maolin2501/REBOOT_RS/reBot-DevArm/media/certification-mark-CN000024-stacked.png

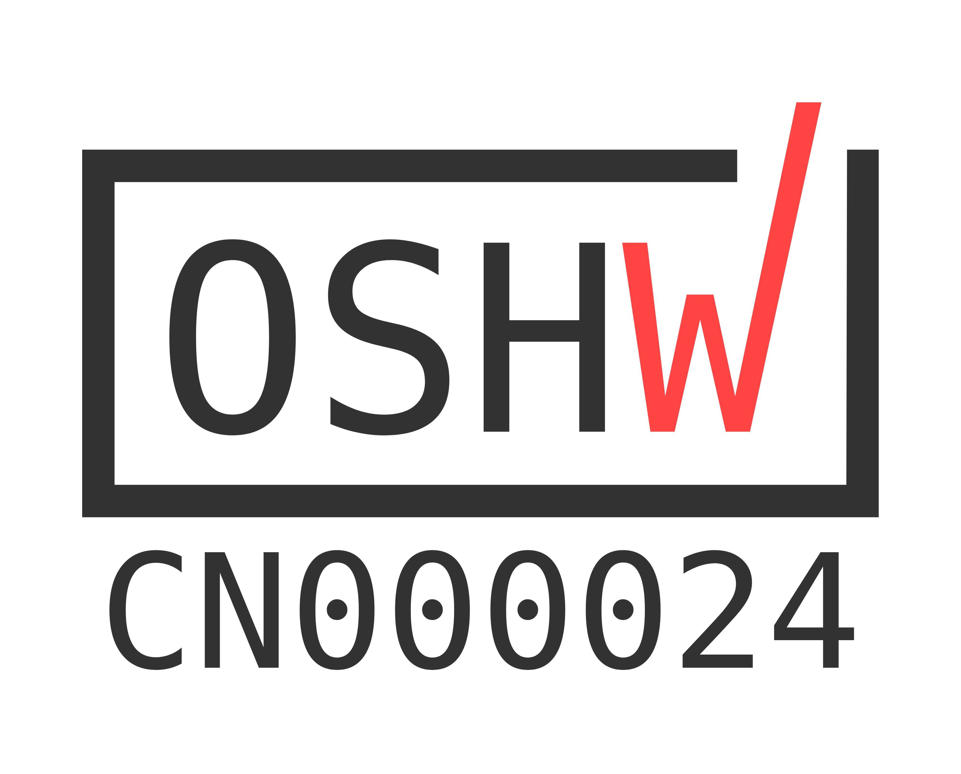
reBot-DevArm/media/certification-mark-CN000024-stacked.png
