maolin2501/REBOOT_RS/reBot-DevArm/media/v1.1_2.png

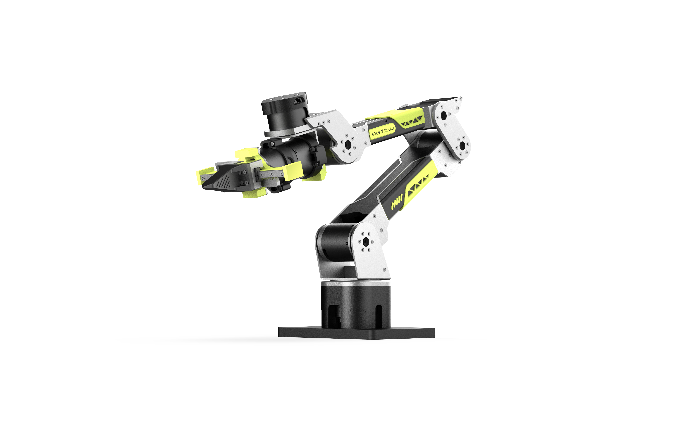
reBot-DevArm/media/v1.1_2.png
