maolin2501/REBOOT_RS/reBotArm_control_py/data/torque_fit_compare.png

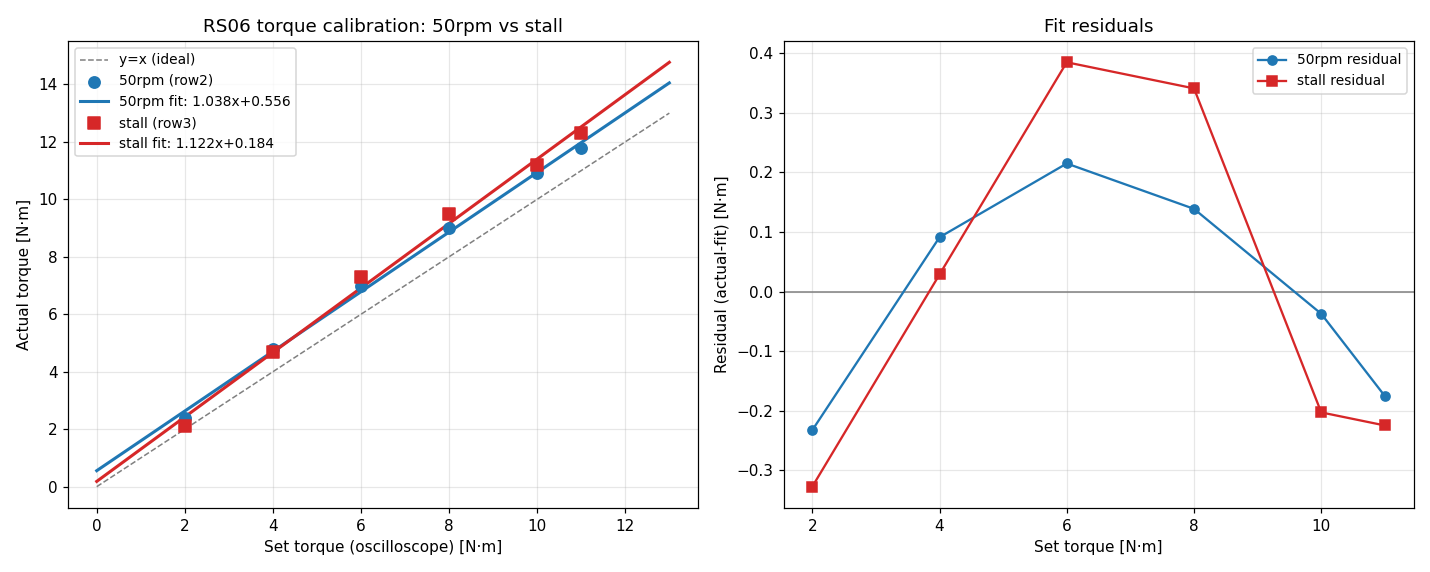
reBotArm_control_py/data/torque_fit_compare.png
