maolin2501/REBOOT_RS/reBot-DevArm/hardware/reBot_B601_DM/3D_Printed_Parts/images/01_Joint6_7_Cable Restraint_A.png

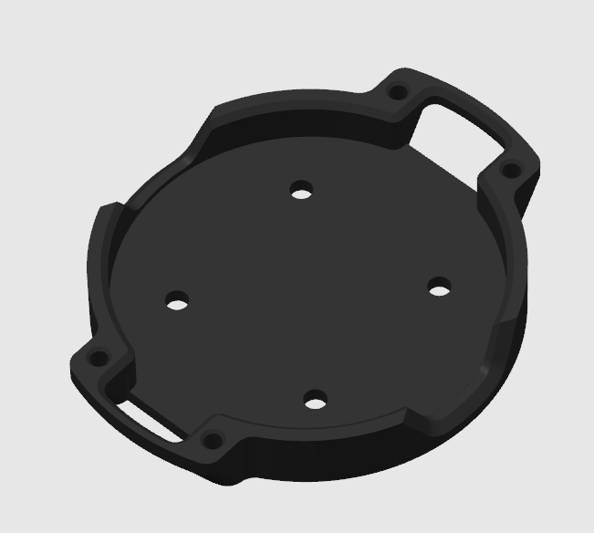
reBot-DevArm/hardware/reBot_B601_DM/3D_Printed_Parts/images/01_Joint6_7_Cable Restraint_A.png
