maolin2501/REBOOT_RS/reBot-DevArm/hardware/reBot_B601_DM/3D_Printed_Parts/images/02-8MM.png

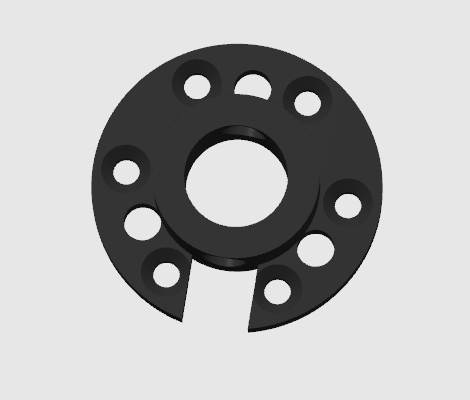
reBot-DevArm/hardware/reBot_B601_DM/3D_Printed_Parts/images/02-8MM.png
