maolin2501/REBOOT_RS/reBot-DevArm/hardware/reBot_B601_DM/Metal_Parts/images/02_Arm_Yaw_Limit.png

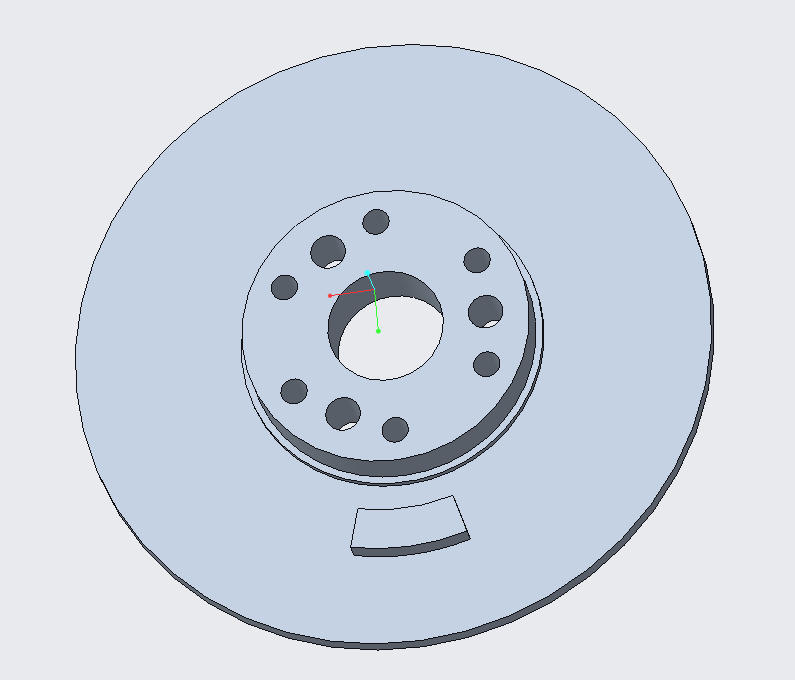
reBot-DevArm/hardware/reBot_B601_DM/Metal_Parts/images/02_Arm_Yaw_Limit.png
