maolin2501/REBOOT_RS/reBot-DevArm/hardware/reBot_B601_DM/Metal_Parts/images/02_Base_Reinforcement_Part.png

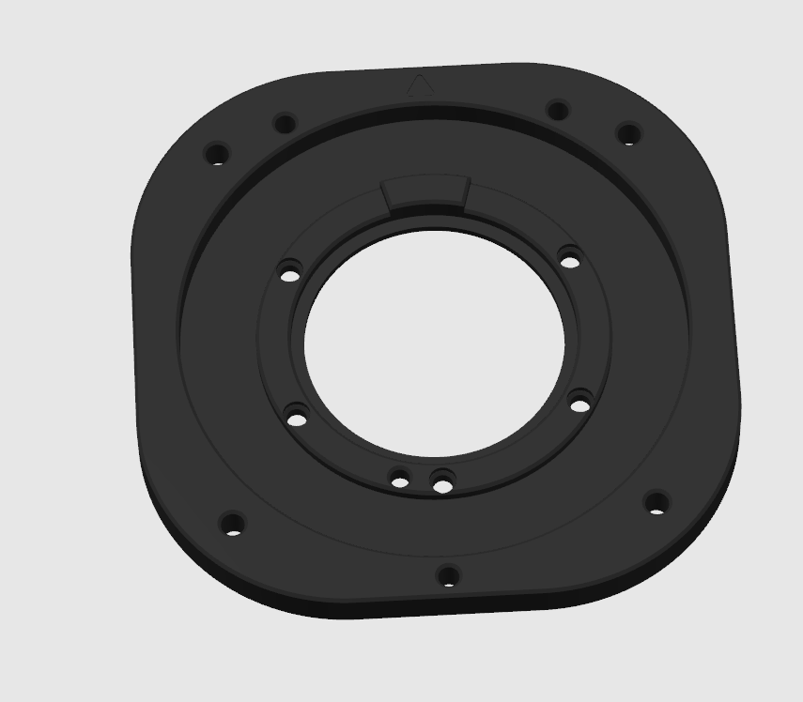
reBot-DevArm/hardware/reBot_B601_DM/Metal_Parts/images/02_Base_Reinforcement_Part.png
