maolin2501/REBOOT_RS/reBot-DevArm/hardware/reBot_B601_DM/Metal_Parts/images/02_Gripper_Connector_B.png

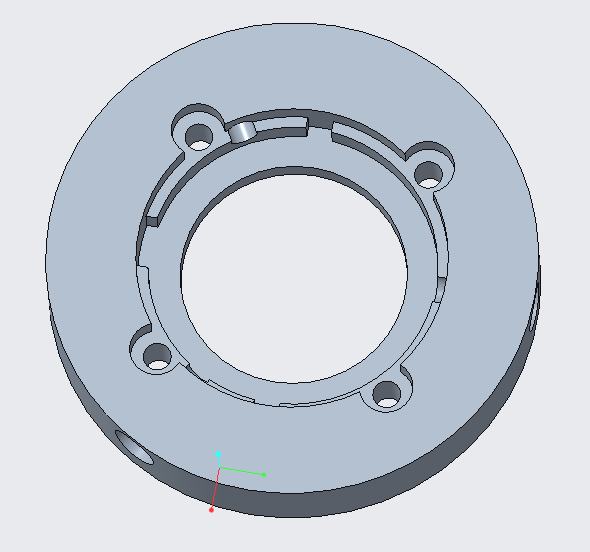
reBot-DevArm/hardware/reBot_B601_DM/Metal_Parts/images/02_Gripper_Connector_B.png
