maolin2501/REBOOT_RS/reBot-DevArm/hardware/reBot_B601_DM/Metal_Parts/images/02_Lower_Upper_Link_L.png

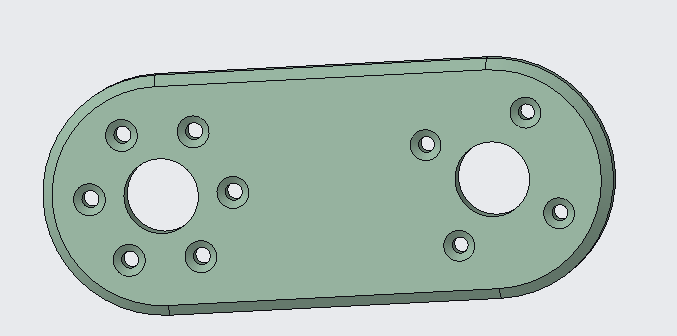
reBot-DevArm/hardware/reBot_B601_DM/Metal_Parts/images/02_Lower_Upper_Link_L.png
