maolin2501/REBOOT_RS/reBot-DevArm/hardware/reBot_B601_DM/Metal_Parts/images/Link5.png

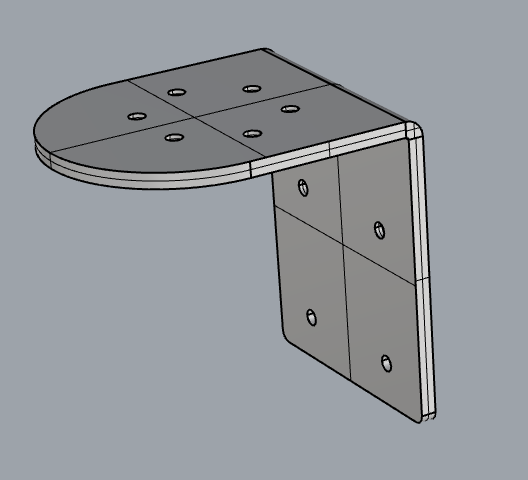
reBot-DevArm/hardware/reBot_B601_DM/Metal_Parts/images/Link5.png
