maolin2501/REBOOT_RS/reBot-DevArm/hardware/reBot_B601_DM/Metal_Parts/images/Rack.png

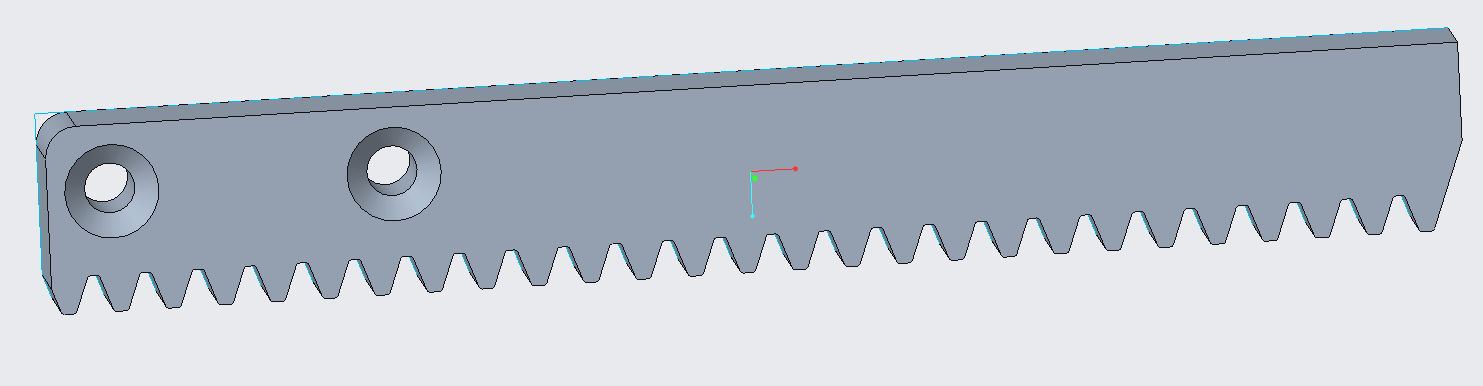
reBot-DevArm/hardware/reBot_B601_DM/Metal_Parts/images/Rack.png
