maolin2501/REBOOT_RS/reBot-DevArm/hardware/reBot_B601_DM/3D_Printed_Parts/01_Upper_Arm_Fuller_L.step

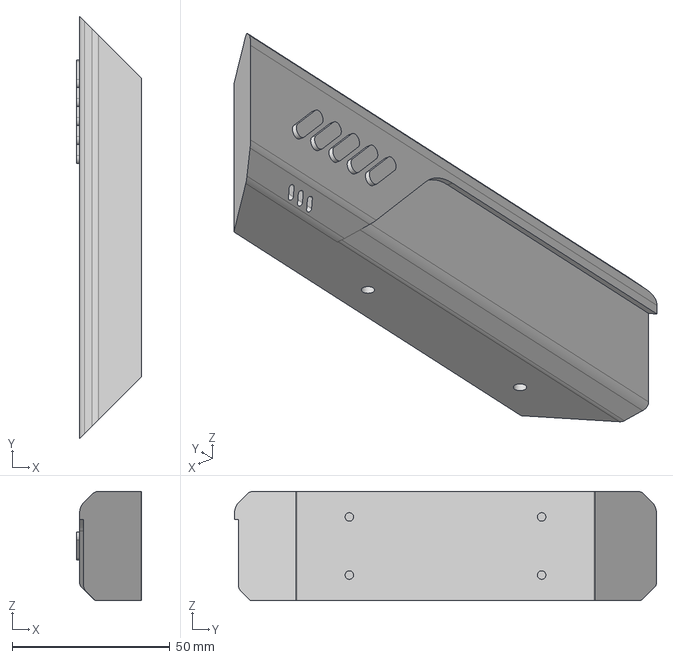
[picture p55: CAD file, 2026-06-09]
reBot-DevArm/hardware/reBot_B601_DM/3D_Printed_Parts/01_Upper_Arm_Fuller_L.step
20.6 x 133.6 x 34.6 mm
