maolin2501/REBOOT_RS/reBot-DevArm/hardware/reBot_B601_DM/3D_Printed_Parts/01_Upper_Arm_Fuller_M.step

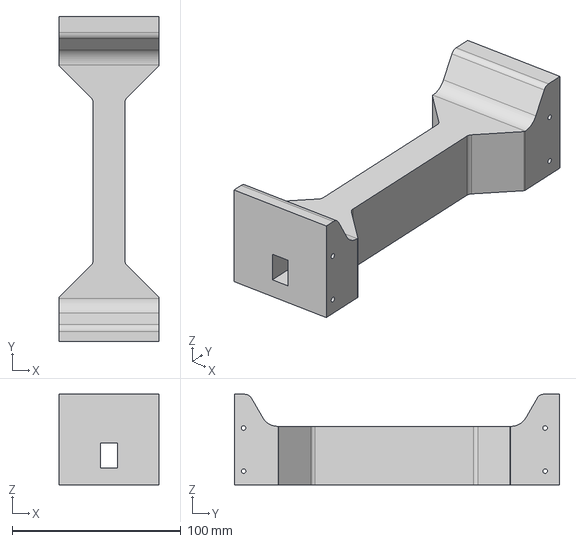
[picture p56: CAD file, 2026-06-09]
reBot-DevArm/hardware/reBot_B601_DM/3D_Printed_Parts/01_Upper_Arm_Fuller_M.step
59.4 x 192.4 x 53.6 mm
