maolin2501/REBOOT_RS/reBot-DevArm/hardware/reBot_B601_DM/3D_Printed_Parts/01_Lower_Arm_Cover.step

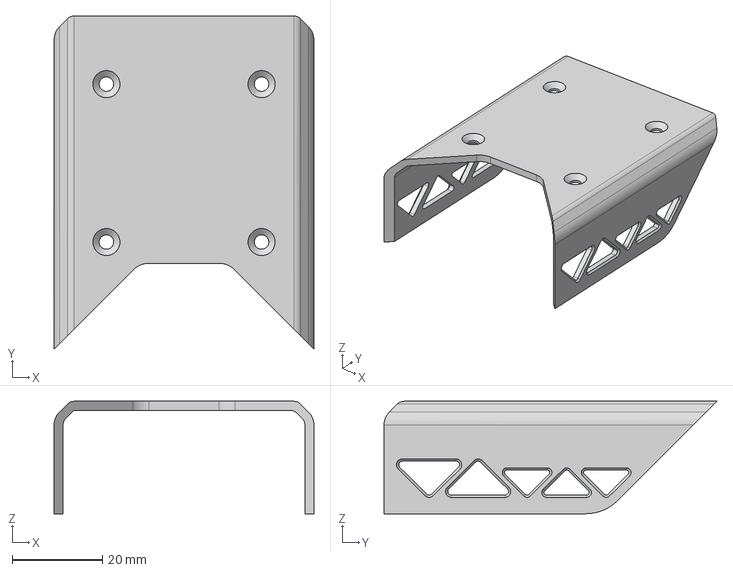
[picture p57: CAD file, 2026-06-09]
reBot-DevArm/hardware/reBot_B601_DM/3D_Printed_Parts/01_Lower_Arm_Cover.step
57.6 x 73.8 x 24.9 mm
