maolin2501/REBOOT_RS/reBot-DevArm/hardware/reBot_B601_DM/Metal_Parts/02_Wrist_Bracket.step

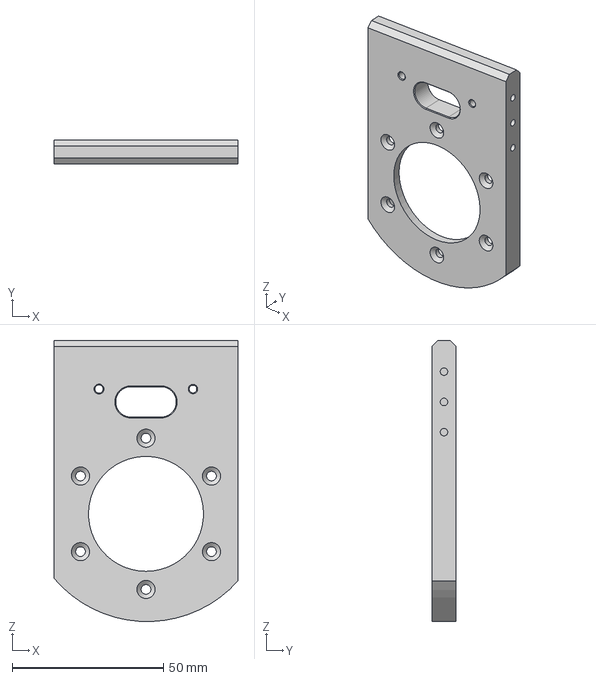
[picture p58: CAD file, 2026-06-09]
reBot-DevArm/hardware/reBot_B601_DM/Metal_Parts/02_Wrist_Bracket.step
60.8 x 8.00 x 92.9 mm
