maolin2501/REBOOT_RS/reBotArm_control_py/urdf/00-arm-rs_asm-v3/meshes/link3.STL

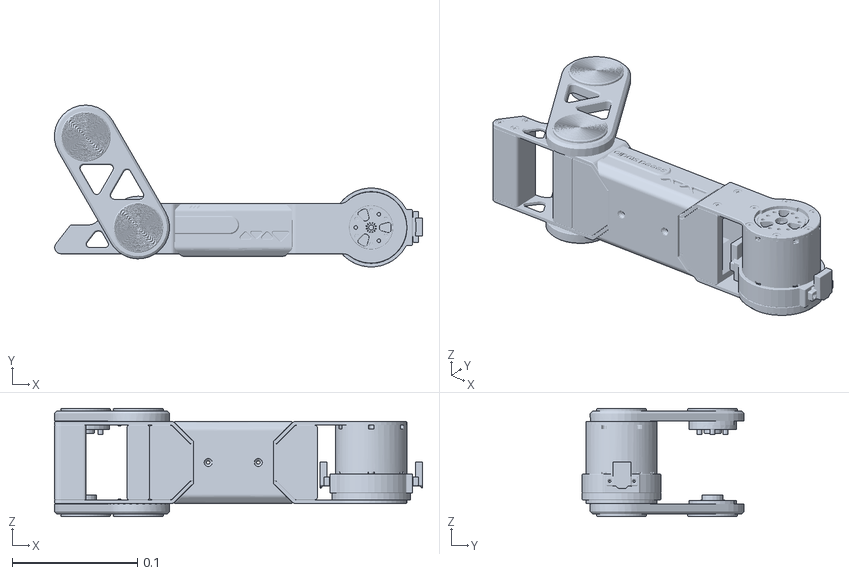
[picture p59: CAD file, 2026-06-09]
reBotArm_control_py/urdf/00-arm-rs_asm-v3/meshes/link3.STL
0.294 x 0.129 x 0.0865
