maolin2501/REBOOT_RS/reBotArm_control_py/urdf/reBot-DevArm_fixend_description/meshes/link1.STL

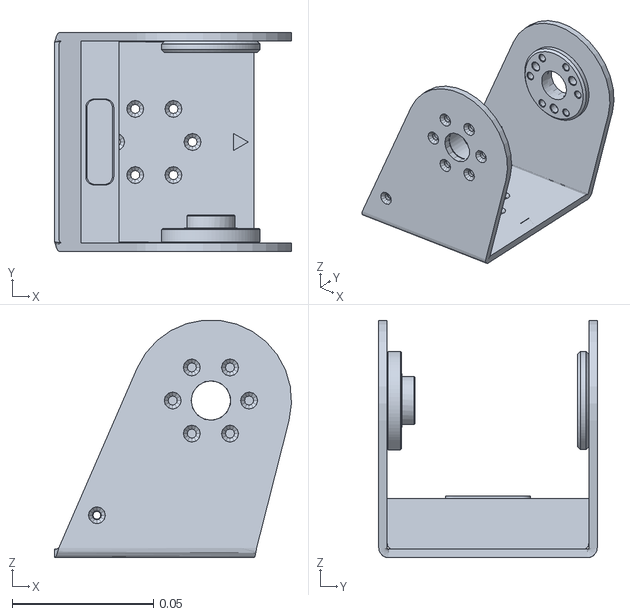
[picture p60: CAD file, 2026-06-09]
reBotArm_control_py/urdf/reBot-DevArm_fixend_description/meshes/link1.STL
0.0838 x 0.0772 x 0.0839
