maolin2501/REBOOT_RS/reBot-DevArm/hardware/reBot_B601_DM/Metal_Parts/02_Motor_Front_Spacer.step

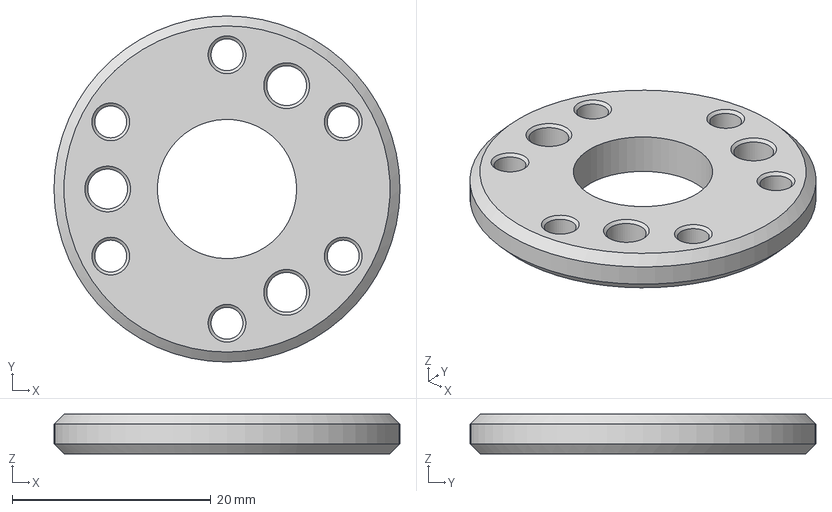
[picture p62: CAD file, 2026-06-09]
reBot-DevArm/hardware/reBot_B601_DM/Metal_Parts/02_Motor_Front_Spacer.step
34.8 x 34.8 x 4.00 mm
