maolin2501/REBOOT_RS/reBotArm_control_py/urdf/00-arm-rs_asm-v3/meshes/link1.STL

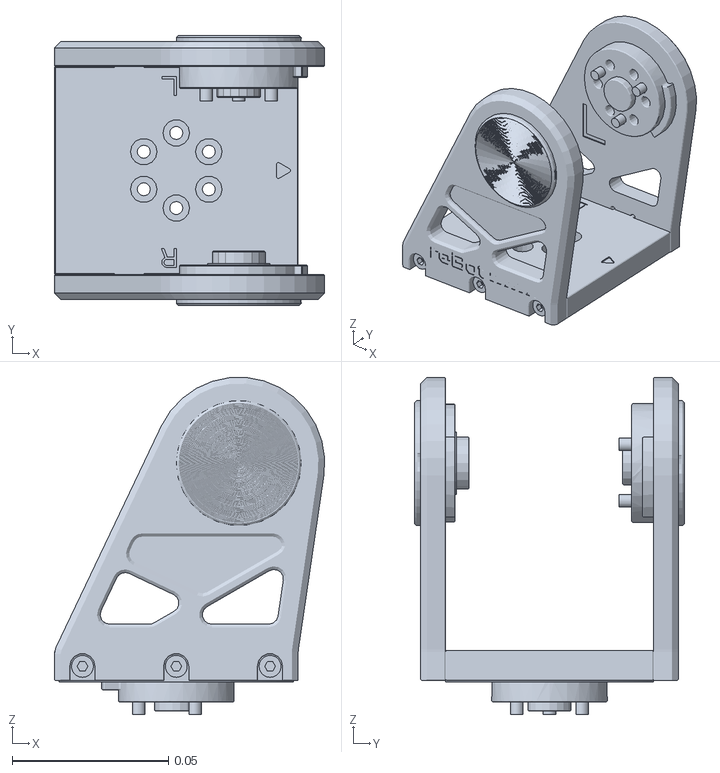
[picture p63: CAD file, 2026-06-09]
reBotArm_control_py/urdf/00-arm-rs_asm-v3/meshes/link1.STL
0.0865 x 0.0865 x 0.108
