maolin2501/REBOOT_RS/reBotArm_control_py/urdf/reBot-DevArm_fixend_description/meshes/base_link.STL

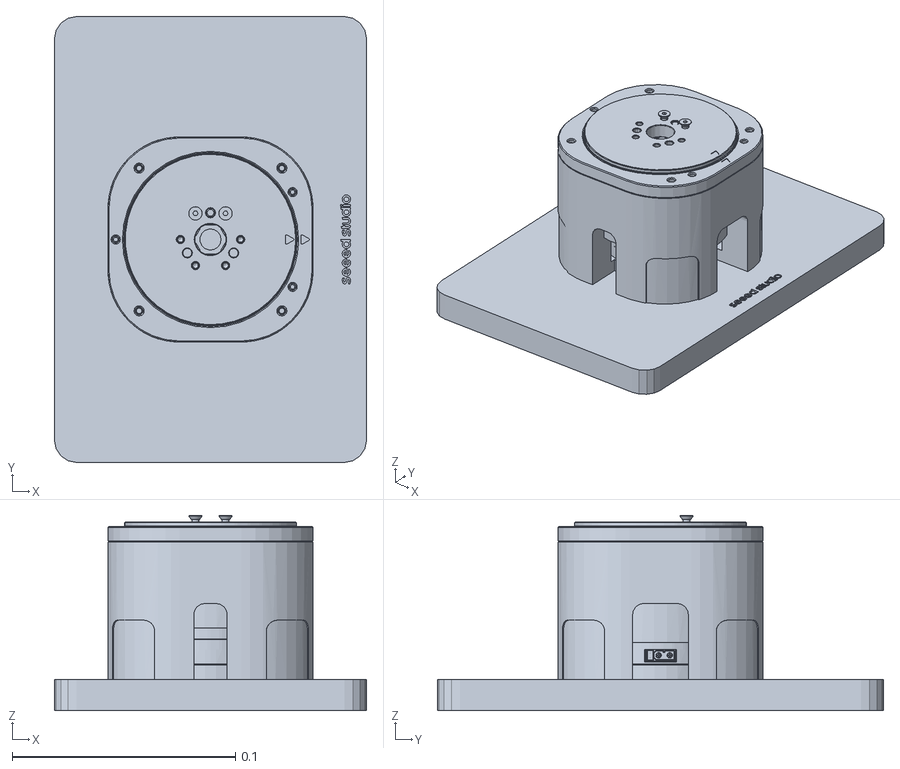
[picture p64: CAD file, 2026-06-09]
reBotArm_control_py/urdf/reBot-DevArm_fixend_description/meshes/base_link.STL
0.14 x 0.2 x 0.0877
