maolin2501/REBOOT_RS/reBot-DevArm/hardware/reBot_B601_DM/3D_Printed_Parts/01_BASE_Plate.step

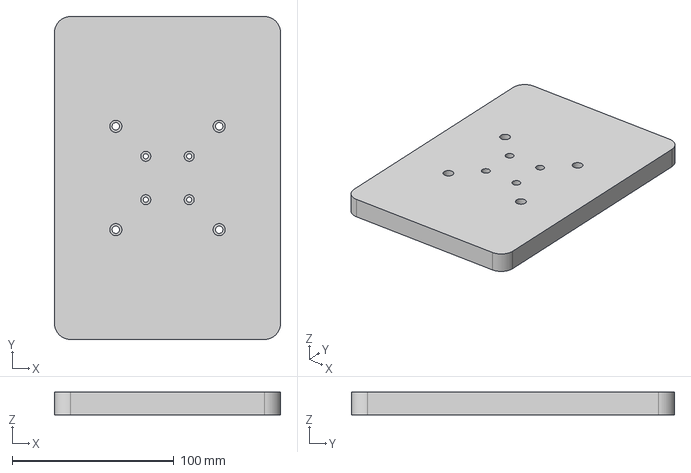
[picture p65: CAD file, 2026-06-09]
reBot-DevArm/hardware/reBot_B601_DM/3D_Printed_Parts/01_BASE_Plate.step
140.0 x 200.0 x 14.0 mm
