maolin2501/REBOOT_RS/reBot-DevArm/hardware/reBot_B601_DM/Metal_Parts/03-Link5.step

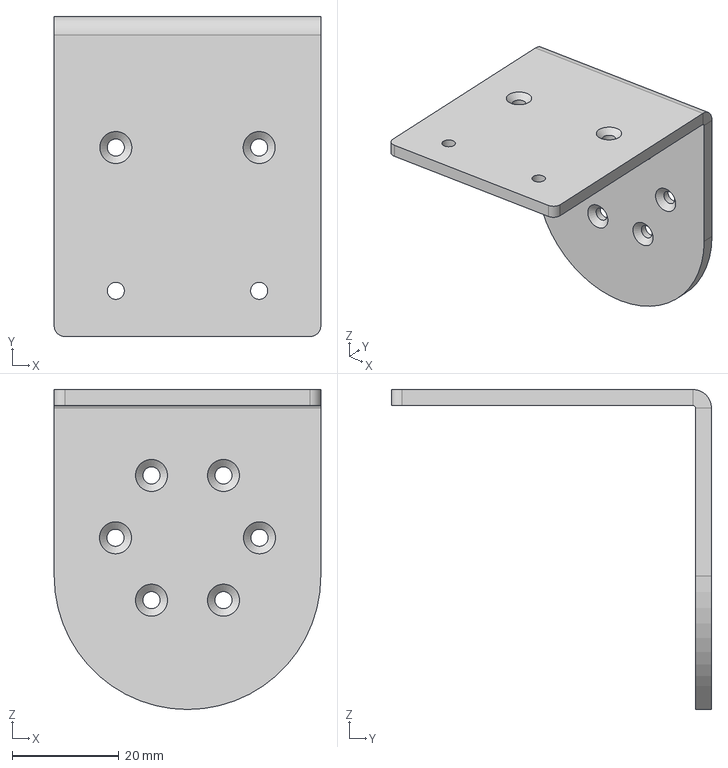
[picture p66: CAD file, 2026-06-09]
reBot-DevArm/hardware/reBot_B601_DM/Metal_Parts/03-Link5.step
50.0 x 60.0 x 60.0 mm
