maolin2501/REBOOT_RS/reBotArm_control_py/urdf/00-arm-rs_asm-v3/meshes/gripper_left.STL

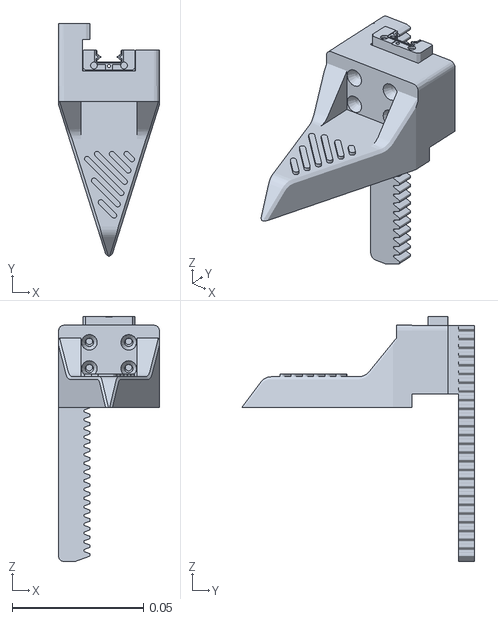
[picture p67: CAD file, 2026-06-09]
reBotArm_control_py/urdf/00-arm-rs_asm-v3/meshes/gripper_left.STL
0.0384 x 0.0886 x 0.0933
