maolin2501/REBOOT_RS/reBotArm_control_py/urdf/reBot-DevArm_fixend_description/meshes/link2.STL

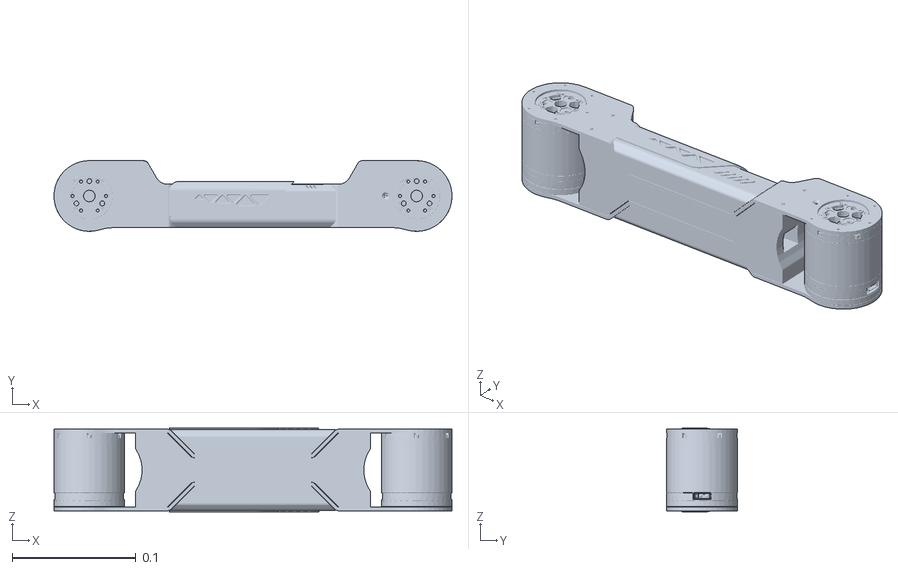
[picture p68: CAD file, 2026-06-09]
reBotArm_control_py/urdf/reBot-DevArm_fixend_description/meshes/link2.STL
0.321 x 0.057 x 0.0674
