maolin2501/REBOOT_RS/reBot-DevArm/hardware/reBot_B601_DM/Metal_Parts/02_Slider_Bracket.step

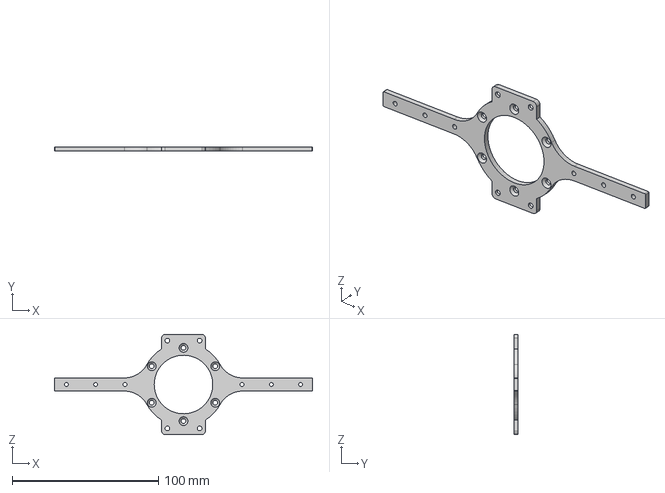
[picture p69: CAD file, 2026-06-09]
reBot-DevArm/hardware/reBot_B601_DM/Metal_Parts/02_Slider_Bracket.step
176.3 x 3.00 x 68.5 mm
