maolin2501/REBOOT_RS/reBotArm_control_py/urdf/00-arm-rs_asm-v3/meshes/cnc3.STL

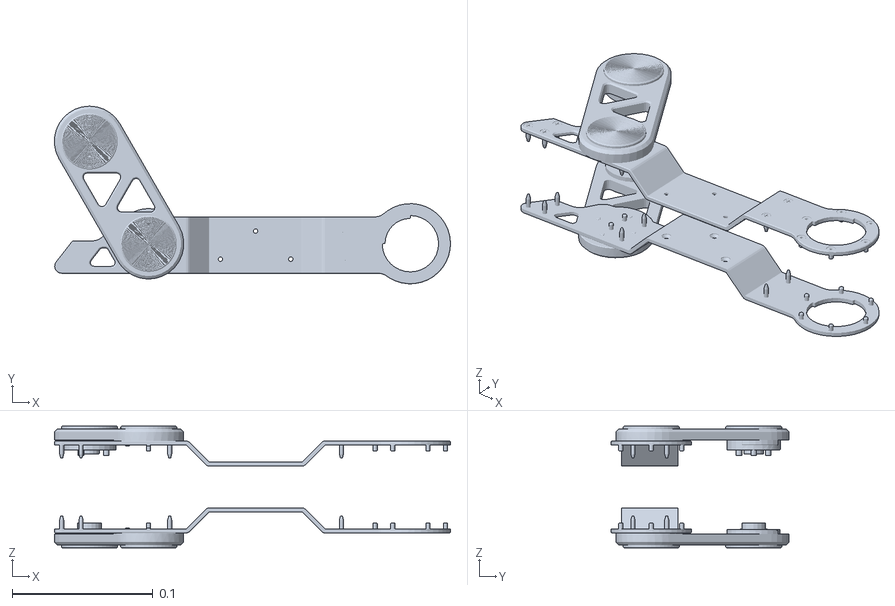
[picture p70: CAD file, 2026-06-09]
reBotArm_control_py/urdf/00-arm-rs_asm-v3/meshes/cnc3.STL
0.281 x 0.126 x 0.0865
