maolin2501/REBOOT_RS/reBotArm_control_py/urdf/reBot-DevArm_fixend_description/meshes/link5.STL

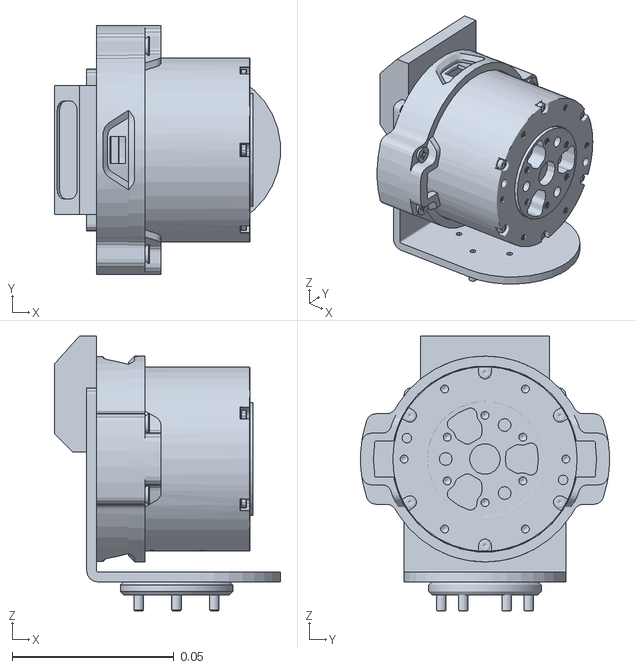
[picture p71: CAD file, 2026-06-09]
reBotArm_control_py/urdf/reBot-DevArm_fixend_description/meshes/link5.STL
0.07 x 0.077 x 0.085
