maolin2501/REBOOT_RS/reBot-DevArm/hardware/reBot_B601_DM/3D_Printed_Parts/01_Joint6_7_Cable Restraint_A.step

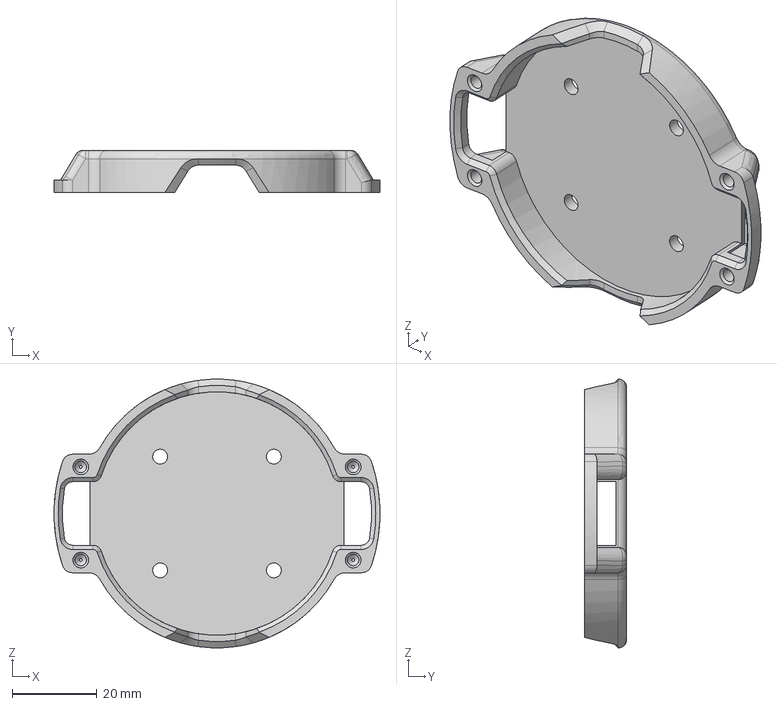
[picture p72: CAD file, 2026-06-09]
reBot-DevArm/hardware/reBot_B601_DM/3D_Printed_Parts/01_Joint6_7_Cable Restraint_A.step
77.0 x 10.0 x 63.5 mm
