maolin2501/REBOOT_RS/reBot-DevArm/hardware/reBot_B601_DM/Metal_Parts/03-Link2.step

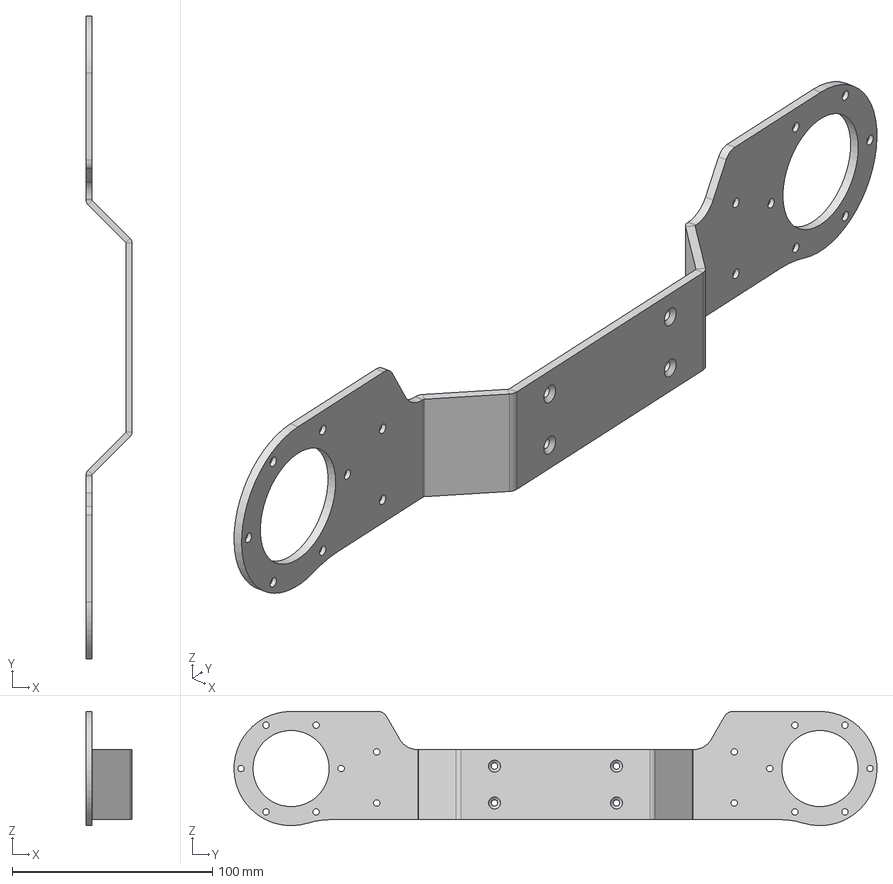
[picture p73: CAD file, 2026-06-09]
reBot-DevArm/hardware/reBot_B601_DM/Metal_Parts/03-Link2.step
23.0 x 321.0 x 57.0 mm
