maolin2501/REBOOT_RS/reBotArm_control_py/urdf/00-arm-rs_asm-v3/meshes/link5.STL

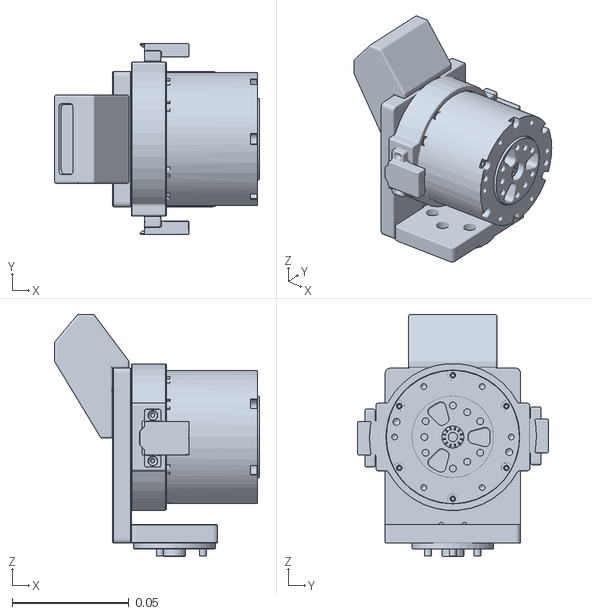
[picture p74: CAD file, 2026-06-09]
reBotArm_control_py/urdf/00-arm-rs_asm-v3/meshes/link5.STL
0.088 x 0.0818 x 0.104
