maolin2501/REBOOT_RS/reBotArm_control_py/urdf/reBot-DevArm_fixend_description/meshes/link4.STL

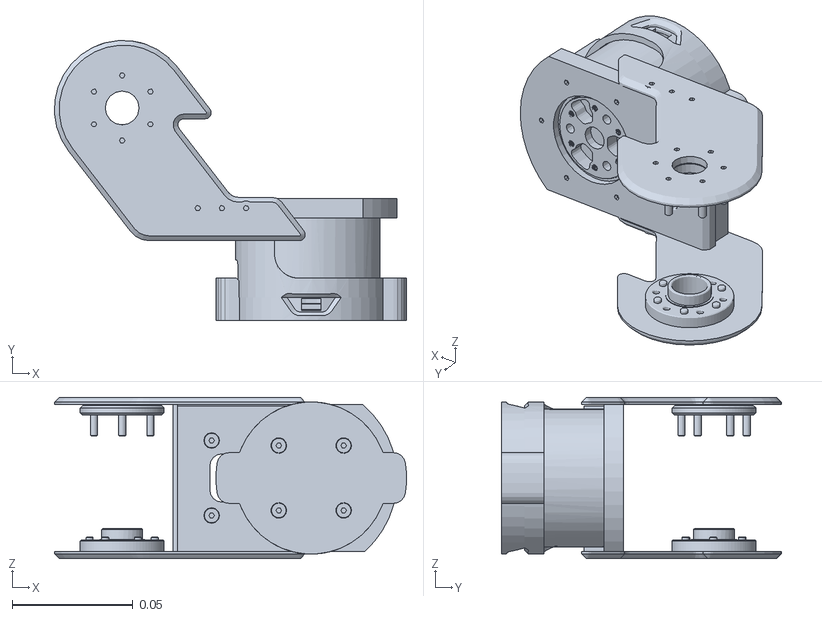
[picture p75: CAD file, 2026-06-09]
reBotArm_control_py/urdf/reBot-DevArm_fixend_description/meshes/link4.STL
0.146 x 0.116 x 0.0668
