maolin2501/REBOOT_RS/reBot-DevArm/hardware/reBot_B601_DM/Metal_Parts/02_Base_Motor_Shim.step

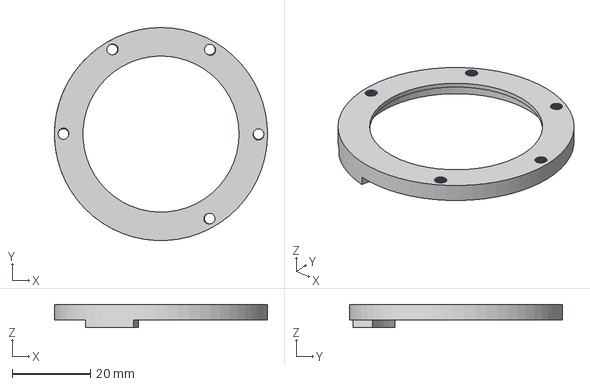
[picture p77: CAD file, 2026-06-09]
reBot-DevArm/hardware/reBot_B601_DM/Metal_Parts/02_Base_Motor_Shim.step
54.6 x 54.6 x 6.00 mm
