maolin2501/REBOOT_RS/reBotArm_control_py/urdf/00-arm-rs_asm-v3/meshes/motor_2_3.STL

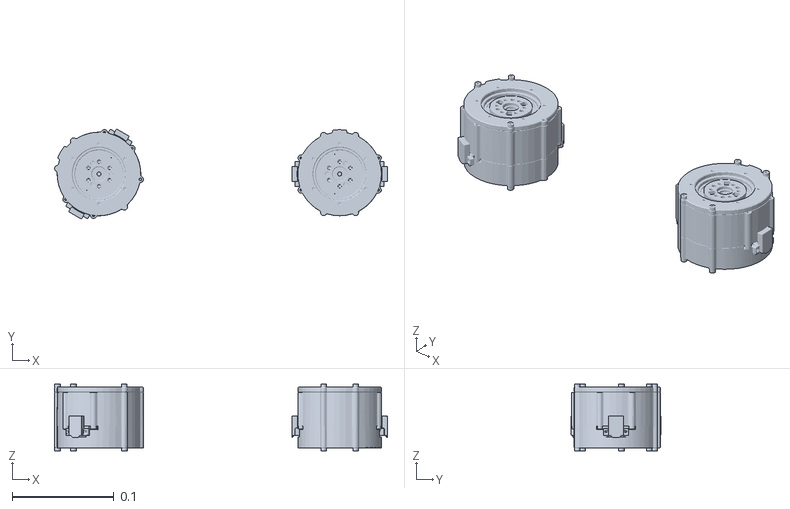
[picture p78: CAD file, 2026-06-09]
reBotArm_control_py/urdf/00-arm-rs_asm-v3/meshes/motor_2_3.STL
0.327 x 0.0881 x 0.0653
