maolin2501/REBOOT_RS/reBot-DevArm/hardware/reBot_B601_DM/Metal_Parts/03-Link1.step

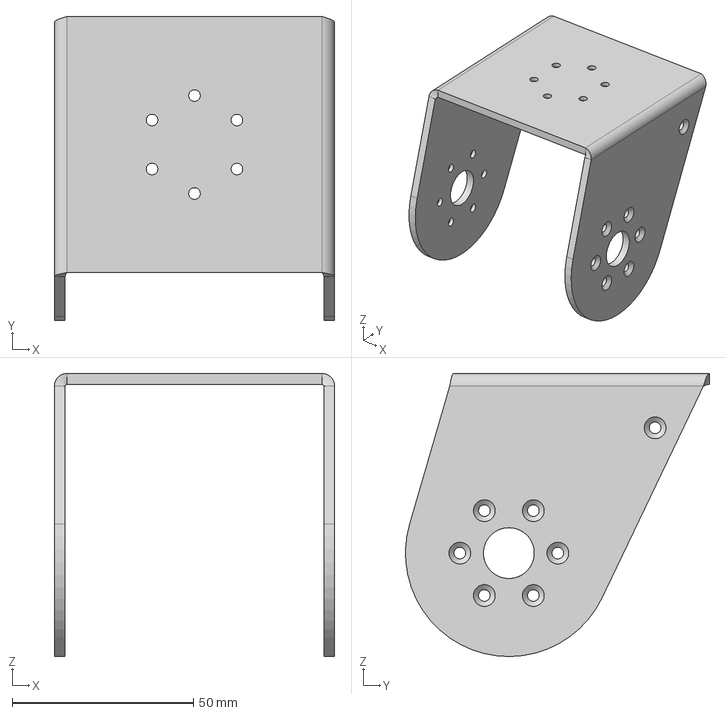
[picture p81: CAD file, 2026-06-09]
reBot-DevArm/hardware/reBot_B601_DM/Metal_Parts/03-Link1.step
77.2 x 83.8 x 78.0 mm
