maolin2501/REBOOT_RS/reBot-DevArm/hardware/reBot_B601_DM/3D_Printed_Parts/01-Rail-Bracket.step

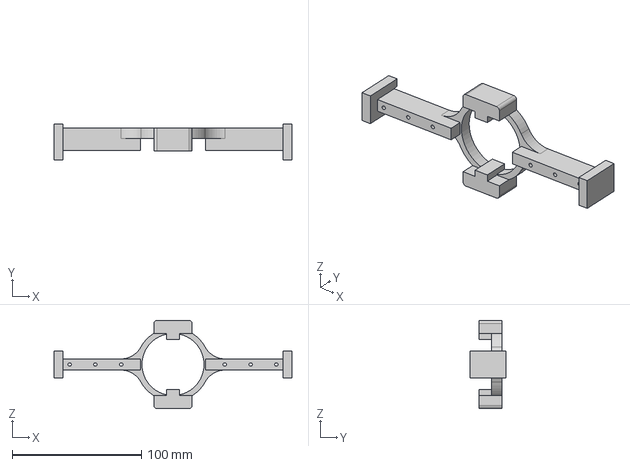
[picture p84: CAD file, 2026-06-09]
reBot-DevArm/hardware/reBot_B601_DM/3D_Printed_Parts/01-Rail-Bracket.step
184.1 x 28.0 x 68.1 mm
