maolin2501/REBOOT_RS/reBot-DevArm/hardware/reBot_B601_DM/Metal_Parts/03-Link3_R.step

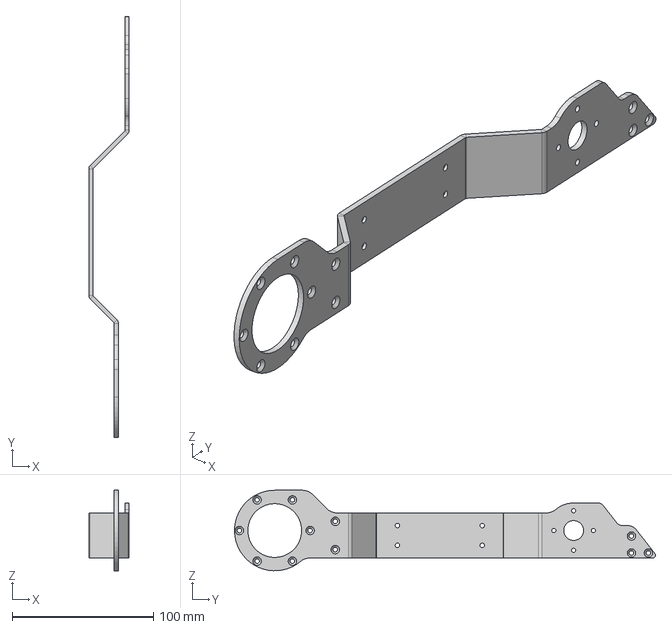
[picture p85: CAD file, 2026-06-09]
reBot-DevArm/hardware/reBot_B601_DM/Metal_Parts/03-Link3_R.step
28.6 x 297.8 x 57.0 mm
