maolin2501/REBOOT_RS/reBotArm_control_py/urdf/00-arm-rs_asm-v3/meshes/pla2_green.STL

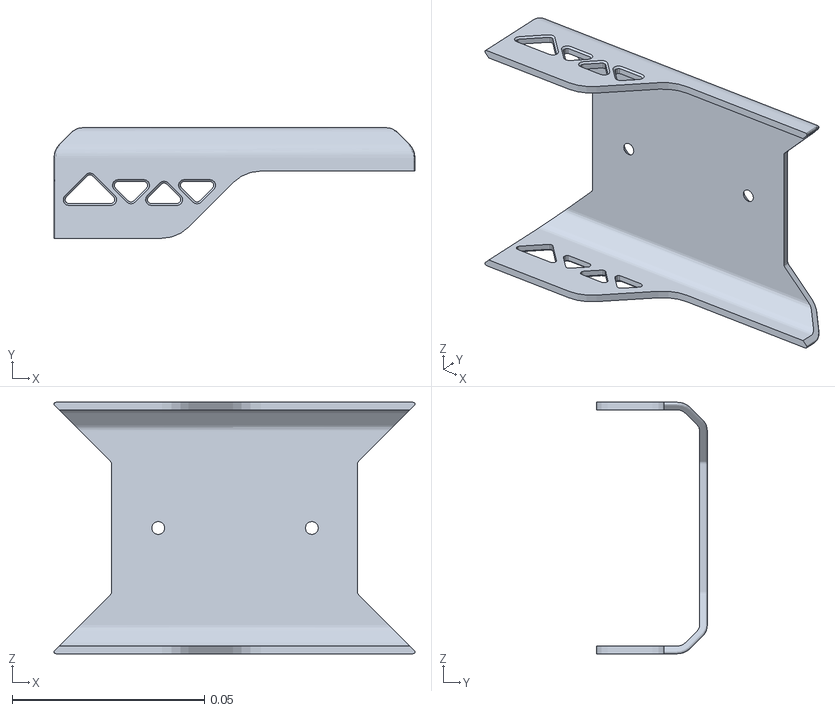
[picture p86: CAD file, 2026-06-09]
reBotArm_control_py/urdf/00-arm-rs_asm-v3/meshes/pla2_green.STL
0.094 x 0.0288 x 0.0655
