maolin2501/REBOOT_RS/reBot-DevArm/hardware/reBot_B601_DM/3D_Printed_Parts/01_Lower_Arm_Filler_L.step

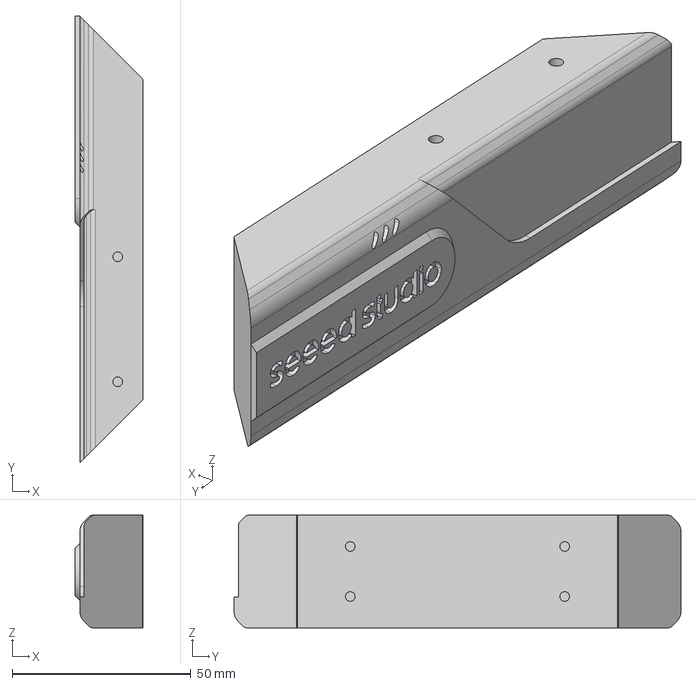
[picture p88: CAD file, 2026-06-09]
reBot-DevArm/hardware/reBot_B601_DM/3D_Printed_Parts/01_Lower_Arm_Filler_L.step
18.9 x 125.0 x 31.6 mm
