maolin2501/REBOOT_RS/reBot-DevArm/hardware/reBot_B601_DM/Metal_Parts/02_Lower_Wrist_Link_R.step

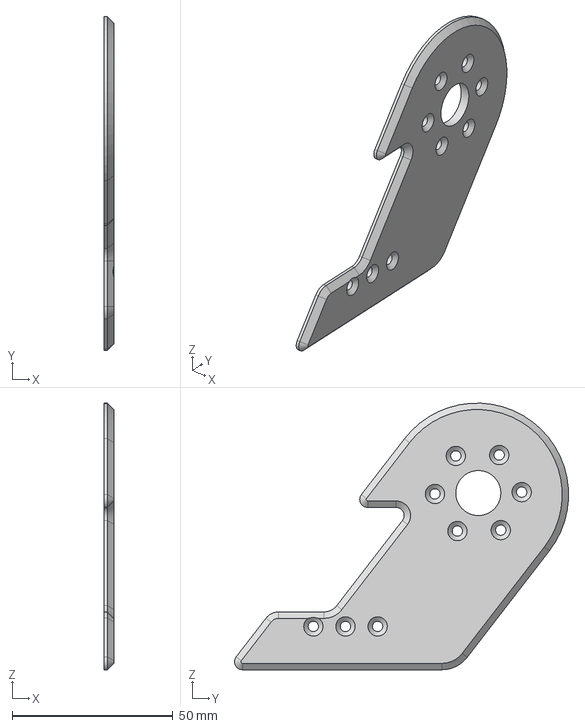
[picture p89: CAD file, 2026-06-09]
reBot-DevArm/hardware/reBot_B601_DM/Metal_Parts/02_Lower_Wrist_Link_R.step
3.00 x 103.9 x 82.9 mm
