maolin2501/REBOOT_RS/reBotArm_control_py/urdf/00-arm-rs_asm-v3/meshes/pla7_green.STL

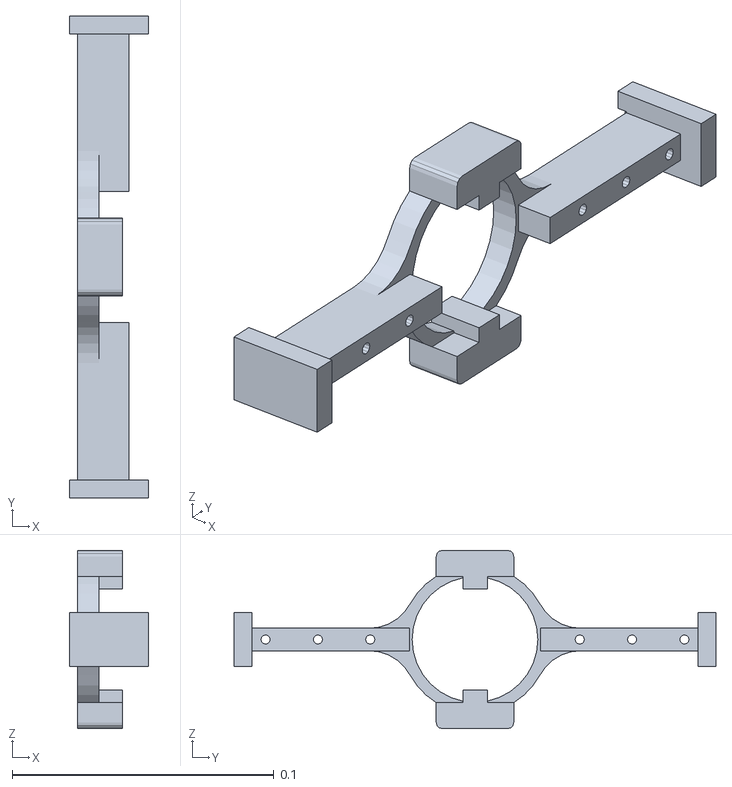
[picture p90: CAD file, 2026-06-09]
reBotArm_control_py/urdf/00-arm-rs_asm-v3/meshes/pla7_green.STL
0.03 x 0.184 x 0.0681
