maolin2501/REBOOT_RS/reBot-DevArm/hardware/reBot_B601_DM/Metal_Parts/02_Slider_Extension.step

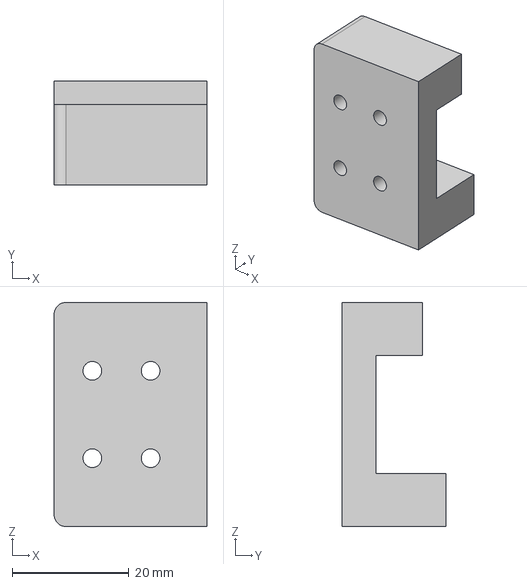
[picture p92: CAD file, 2026-06-09]
reBot-DevArm/hardware/reBot_B601_DM/Metal_Parts/02_Slider_Extension.step
26.2 x 17.8 x 38.4 mm
