maolin2501/REBOOT_RS/reBot-DevArm/hardware/reBot_B601_DM/3D_Printed_Parts/01_Upper_Arm_Cover.step

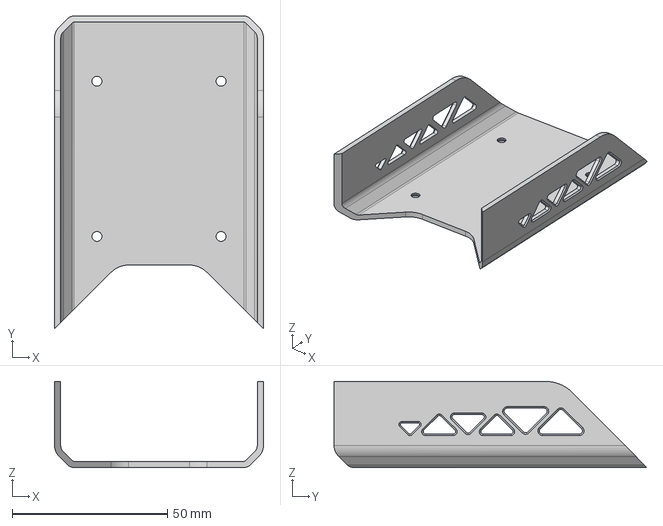
[picture p94: CAD file, 2026-06-09]
reBot-DevArm/hardware/reBot_B601_DM/3D_Printed_Parts/01_Upper_Arm_Cover.step
67.4 x 100.8 x 27.7 mm
