maolin2501/REBOOT_RS/reBotArm_control_py/urdf/00-arm-rs_asm-v3/meshes/pla_right.STL

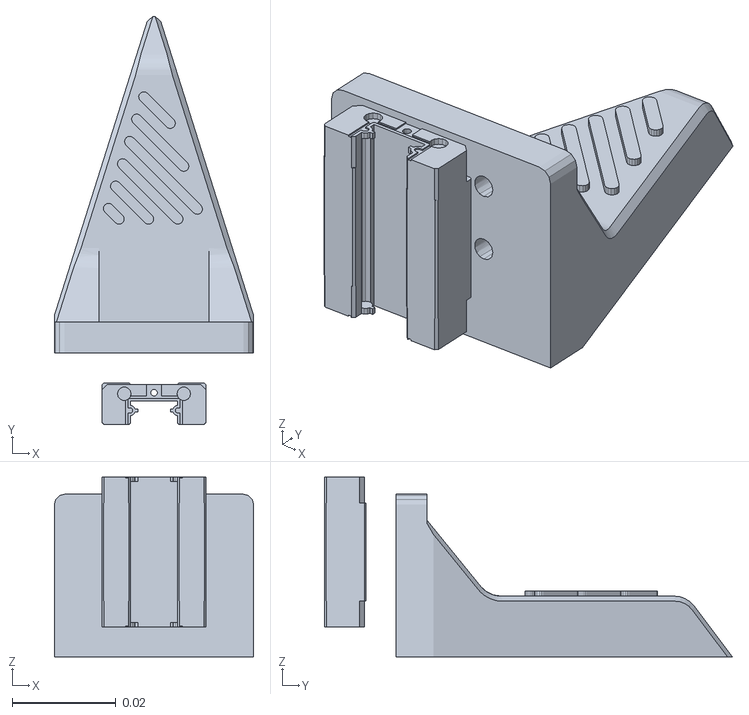
[picture p95: CAD file, 2026-06-09]
reBotArm_control_py/urdf/00-arm-rs_asm-v3/meshes/pla_right.STL
0.0384 x 0.0786 x 0.0347
