maolin2501/REBOOT_RS/reBot-DevArm/hardware/reBot_B601_DM/3D_Printed_Parts/D405_305_Mount.step

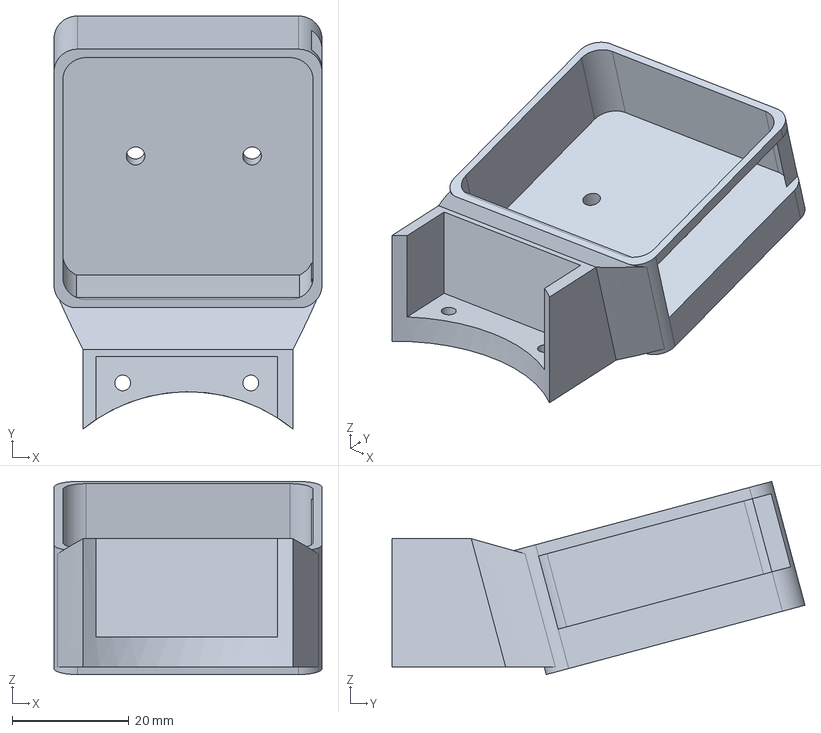
[picture p96: CAD file, 2026-06-09]
reBot-DevArm/hardware/reBot_B601_DM/3D_Printed_Parts/D405_305_Mount.step
46.0 x 70.9 x 33.2 mm
