maolin2501/REBOOT_RS/reBot-DevArm/hardware/reBot_B601_DM/Metal_Parts/02_Gripper_Connector_B.step

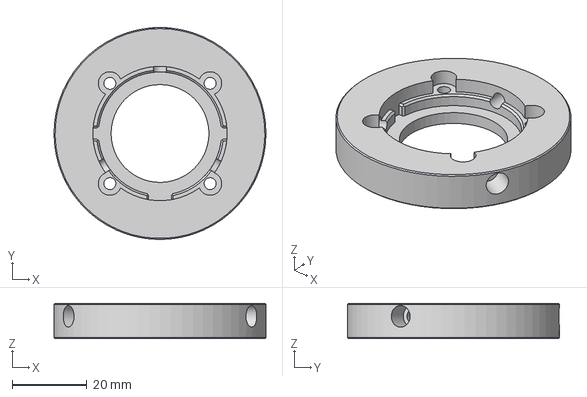
[picture p97: CAD file, 2026-06-09]
reBot-DevArm/hardware/reBot_B601_DM/Metal_Parts/02_Gripper_Connector_B.step
56.8 x 56.8 x 9.50 mm
