maolin2501/REBOOT_RS/reBot-DevArm/hardware/reBot_B601_DM/3D_Printed_Parts/Soft_Gripper_Finger.step

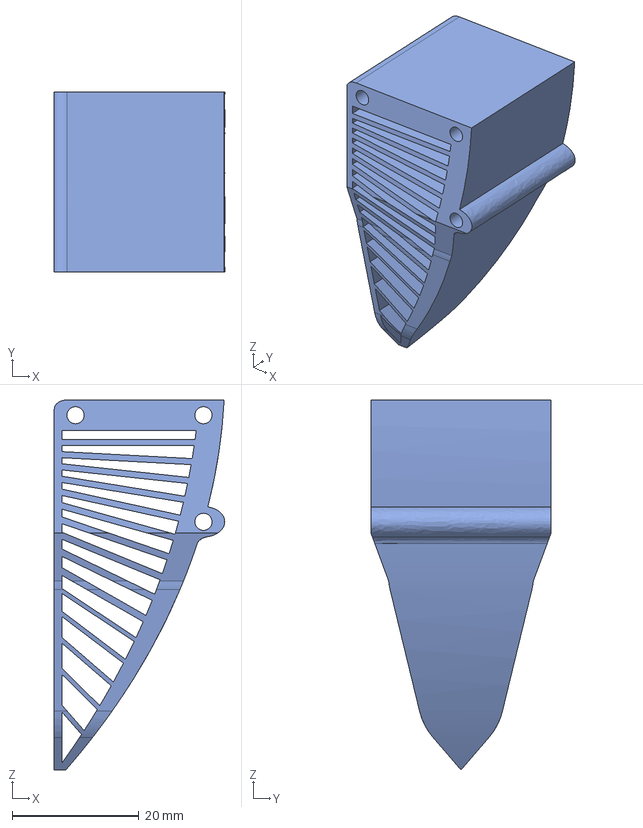
[picture p99: CAD file, 2026-06-09]
reBot-DevArm/hardware/reBot_B601_DM/3D_Printed_Parts/Soft_Gripper_Finger.step
26.9 x 28.4 x 58.3 mm
