maolin2501/REBOOT_RS/reBot-DevArm/hardware/reBot_B601_DM/3D_Printed_Parts/UVC32_mount.step

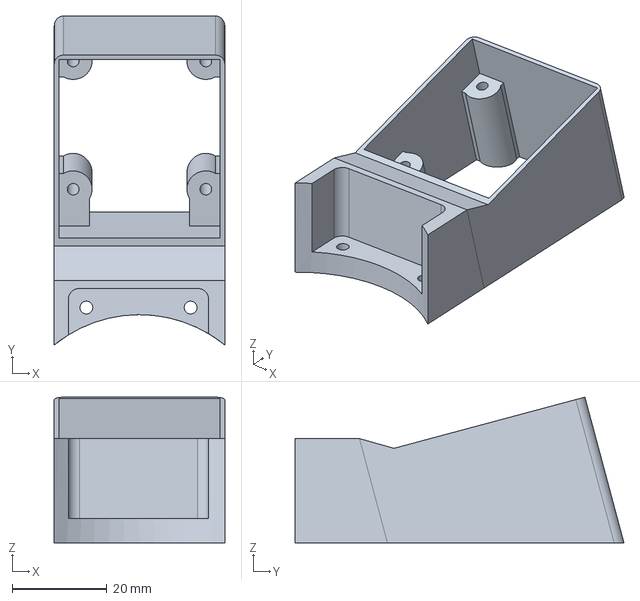
[picture p104: CAD file, 2026-06-09]
reBot-DevArm/hardware/reBot_B601_DM/3D_Printed_Parts/UVC32_mount.step
36.0 x 69.4 x 30.8 mm
