maolin2501/REBOOT_RS/reBot-DevArm/hardware/reBot_B601_DM/Metal_Parts/02_Motor_Back_Spacer.step

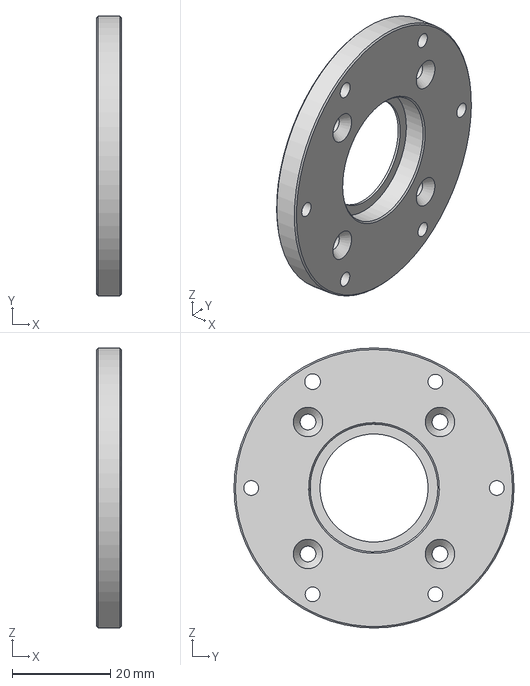
[picture p105: CAD file, 2026-06-09]
reBot-DevArm/hardware/reBot_B601_DM/Metal_Parts/02_Motor_Back_Spacer.step
5.00 x 57.0 x 57.0 mm
