maolin2501/REBOOT_RS/reBot-DevArm/hardware/reBot_B601_DM/Metal_Parts/02_Base_Reinforcement_Part.step

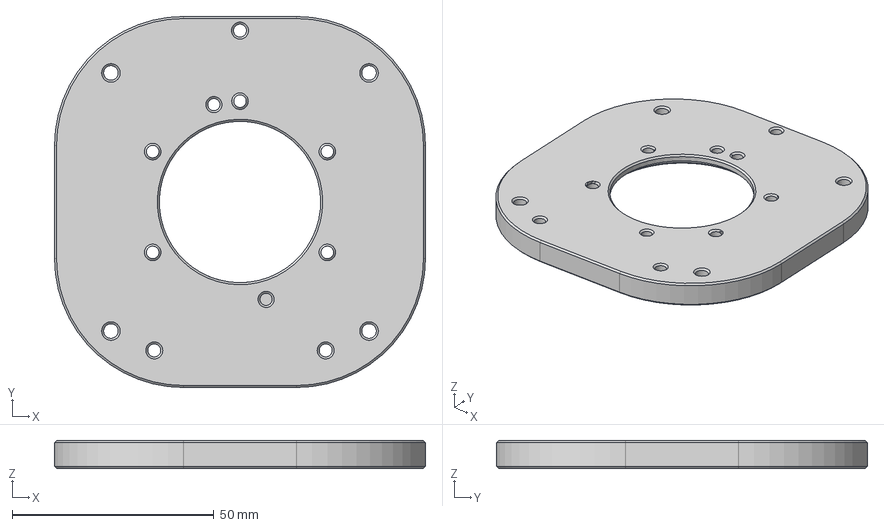
[picture p107: CAD file, 2026-06-09]
reBot-DevArm/hardware/reBot_B601_DM/Metal_Parts/02_Base_Reinforcement_Part.step
92.0 x 92.0 x 6.95 mm
