maolin2501/REBOOT_RS/reBot-DevArm/hardware/reBot_B601_DM/3D_Printed_Parts/D435_Gemini2_Mount.step

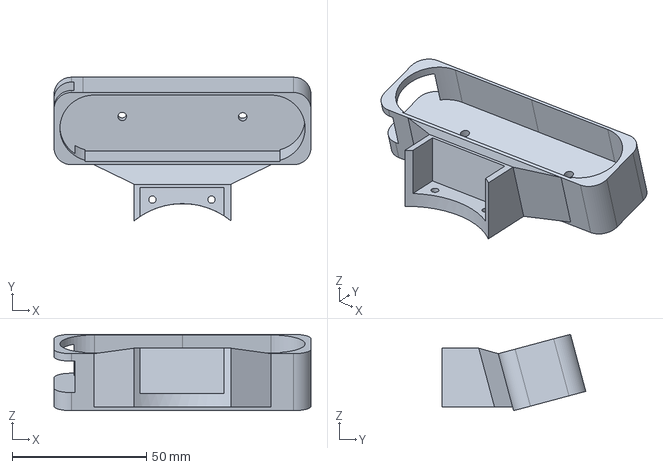
[picture p108: CAD file, 2026-06-09]
reBot-DevArm/hardware/reBot_B601_DM/3D_Printed_Parts/D435_Gemini2_Mount.step
95.8 x 53.5 x 28.5 mm
