maolin2501/REBOOT_RS/reBot-DevArm/hardware/reBot_B601_DM/Metal_Parts/02_Gear_Connector.step

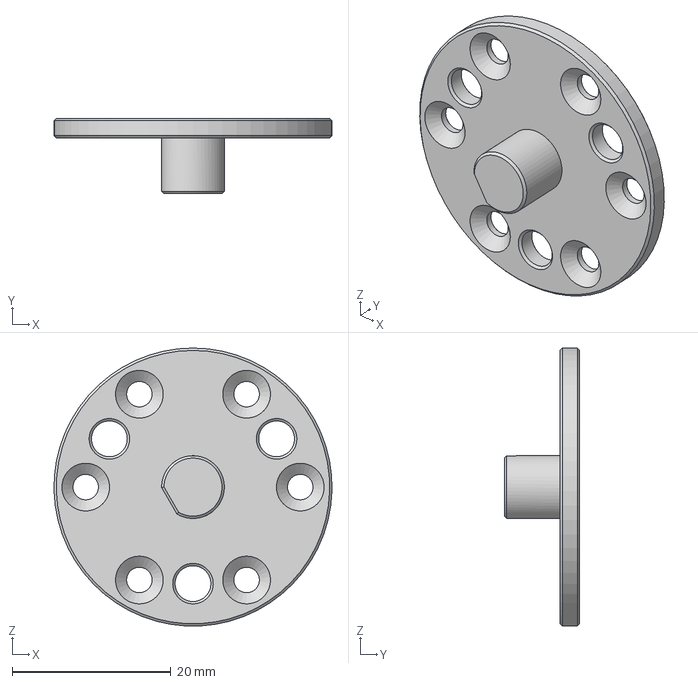
[picture p109: CAD file, 2026-06-09]
reBot-DevArm/hardware/reBot_B601_DM/Metal_Parts/02_Gear_Connector.step
35.0 x 9.50 x 35.0 mm
