maolin2501/REBOOT_RS/reBot-DevArm/hardware/reBot_B601_DM/3D_Printed_Parts/01_Lower_Arm_Filler_M.step

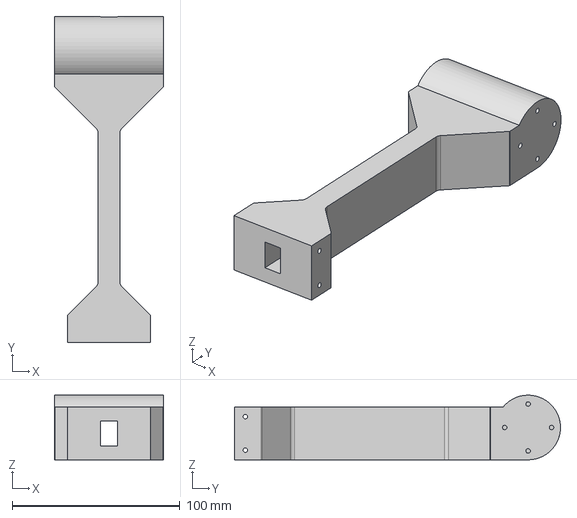
[picture p111: CAD file, 2026-06-09]
reBot-DevArm/hardware/reBot_B601_DM/3D_Printed_Parts/01_Lower_Arm_Filler_M.step
64.8 x 194.4 x 38.6 mm
