maolin2501/REBOOT_RS/reBot-DevArm/hardware/reBot_B601_DM/Metal_Parts/02_Lower_Upper_Link_L.step

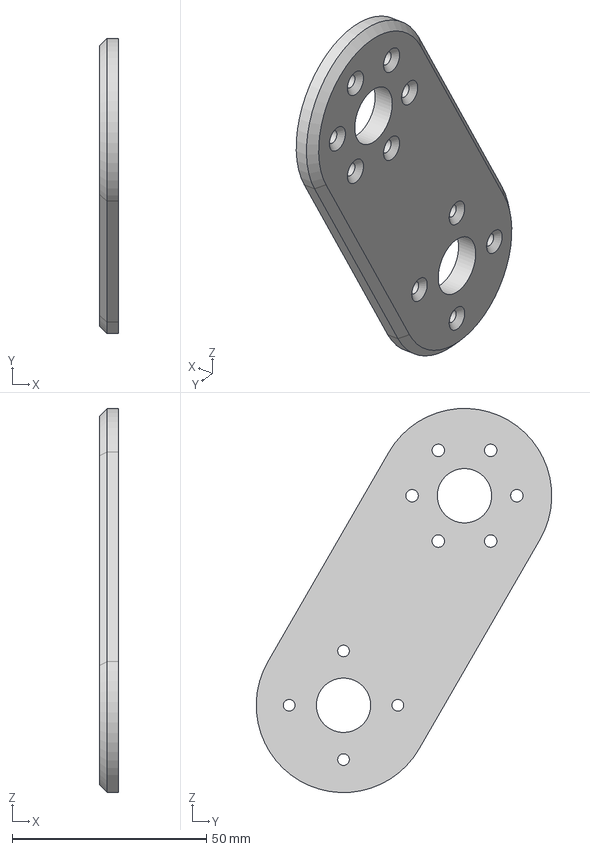
[picture p112: CAD file, 2026-06-09]
reBot-DevArm/hardware/reBot_B601_DM/Metal_Parts/02_Lower_Upper_Link_L.step
5.00 x 76.1 x 99.0 mm
