maolin2501/REBOOT_RS/reBotArm_control_py/urdf/00-arm-rs_asm-v3/meshes/motor_7.STL

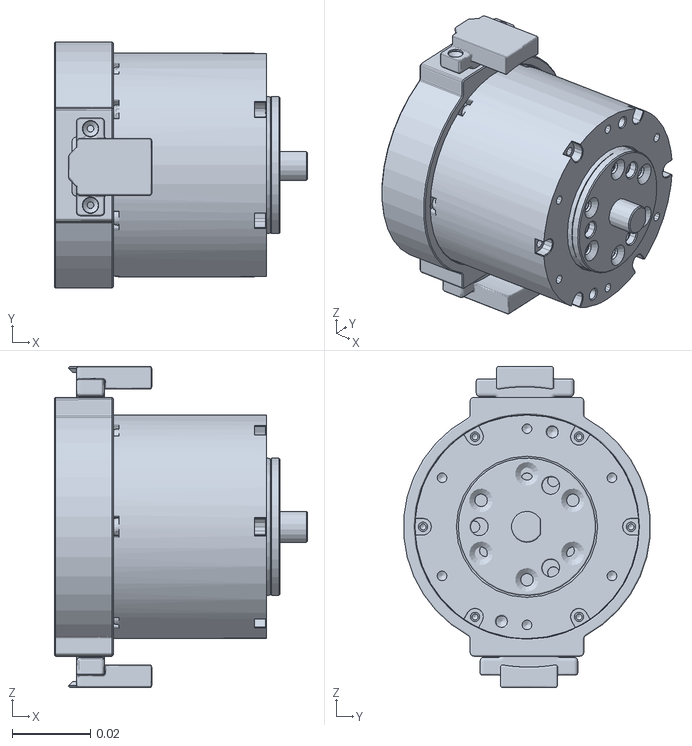
[picture p113: CAD file, 2026-06-09]
reBotArm_control_py/urdf/00-arm-rs_asm-v3/meshes/motor_7.STL
0.0645 x 0.0628 x 0.0818
