maolin2501/REBOOT_RS/reBot-DevArm/hardware/reBot_B601_DM/3D_Printed_Parts/01_Upper_Arm_Limit.step

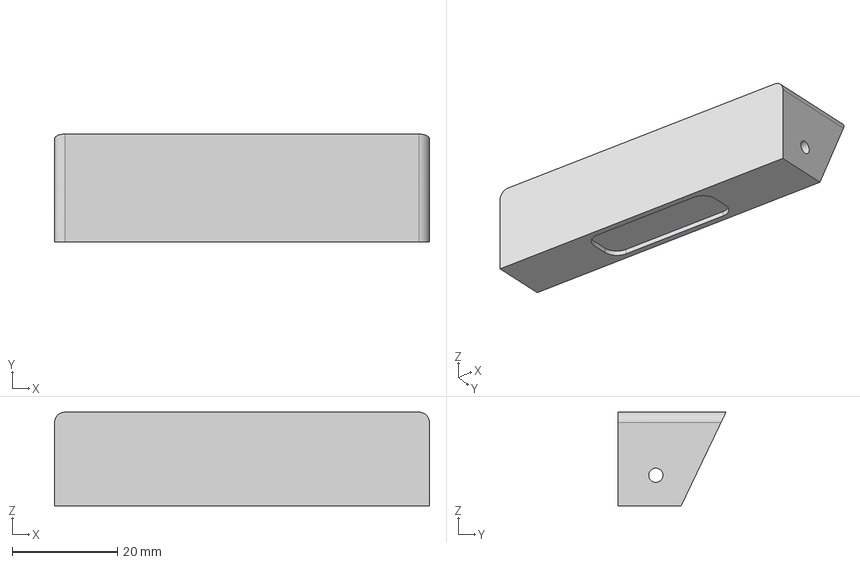
[picture p115: CAD file, 2026-06-09]
reBot-DevArm/hardware/reBot_B601_DM/3D_Printed_Parts/01_Upper_Arm_Limit.step
71.2 x 20.5 x 17.8 mm
