maolin2501/REBOOT_RS/reBot-DevArm/hardware/reBot_B601_DM/Metal_Parts/02_Gripper_Connector_A.step

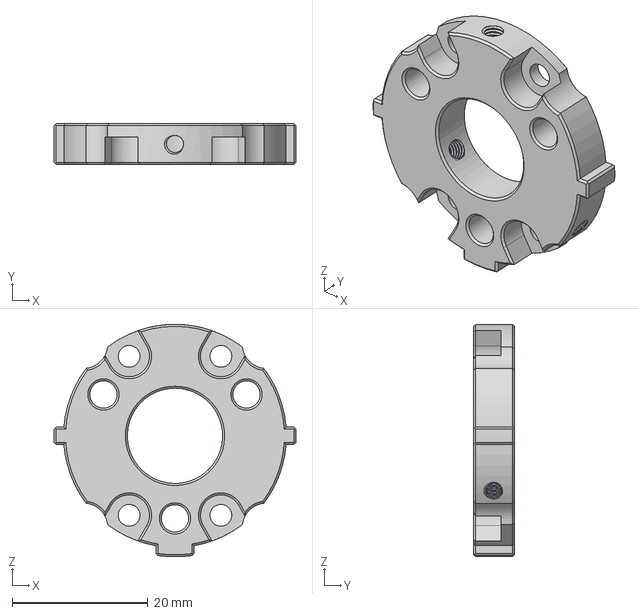
[picture p118: CAD file, 2026-06-09]
reBot-DevArm/hardware/reBot_B601_DM/Metal_Parts/02_Gripper_Connector_A.step
35.6 x 6.00 x 34.2 mm
