maolin2501/REBOOT_RS/reBot-DevArm/hardware/reBot_B601_DM/3D_Printed_Parts/01_Lower_Arm_Limit.step

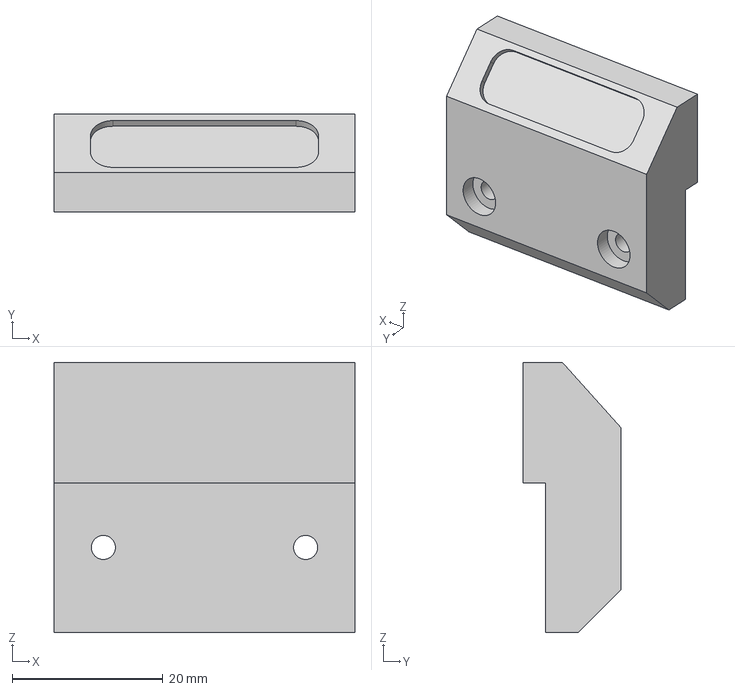
[picture p120: CAD file, 2026-06-09]
reBot-DevArm/hardware/reBot_B601_DM/3D_Printed_Parts/01_Lower_Arm_Limit.step
40.0 x 13.0 x 35.9 mm
