maolin2501/REBOOT_RS/reBot-DevArm/hardware/reBot_B601_DM/Metal_Parts/02_Arm_Yaw_Limit.step

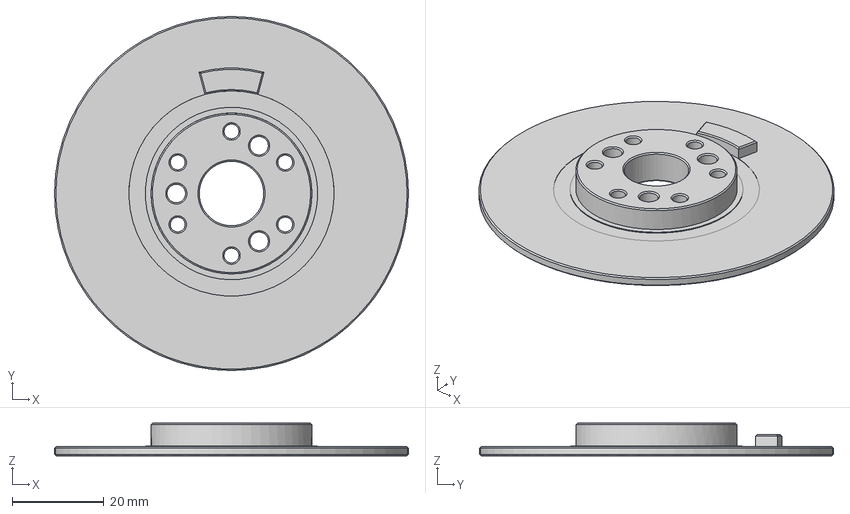
[picture p121: CAD file, 2026-06-09]
reBot-DevArm/hardware/reBot_B601_DM/Metal_Parts/02_Arm_Yaw_Limit.step
77.0 x 77.0 x 7.10 mm
