maolin2501/REBOOT_RS/reBotArm_control_py/urdf/00-arm-rs_asm-v3/meshes/pla2_black.STL

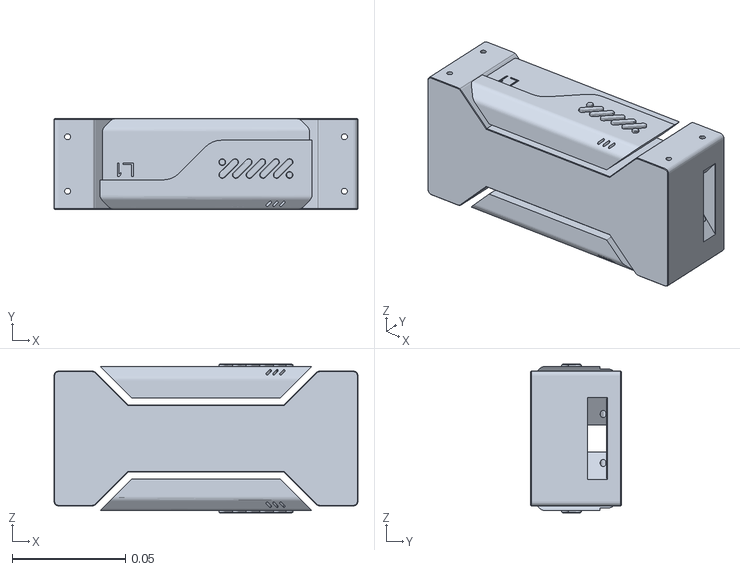
[picture p126: CAD file, 2026-06-09]
reBotArm_control_py/urdf/00-arm-rs_asm-v3/meshes/pla2_black.STL
0.134 x 0.04 x 0.0655
