maolin2501/REBOOT_RS/reBotArm_control_py/urdf/00-arm-rs_asm-v3/meshes/gripper_end.STL

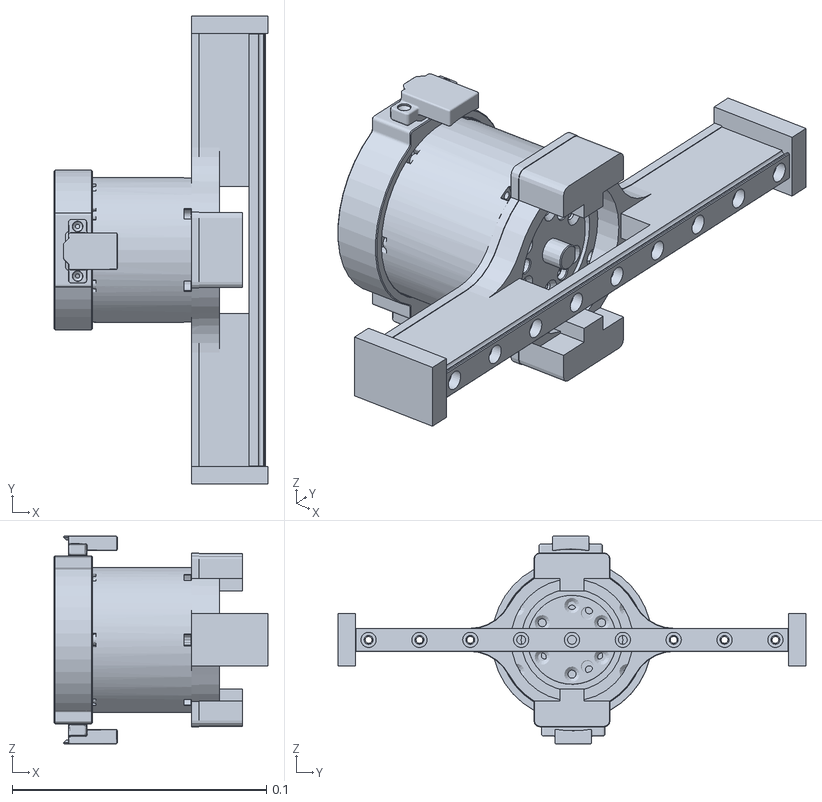
[picture p128: CAD file, 2026-06-09]
reBotArm_control_py/urdf/00-arm-rs_asm-v3/meshes/gripper_end.STL
0.084 x 0.184 x 0.0818
