maolin2501/REBOOT_RS/(list of files, cad)

Other CAD files:
reBot-DevArm/hardware/reBot_B601_DM/3D_Printed_Parts/01_Upper_Arm_Fuller_R.step
reBot-DevArm/hardware/reBot_B601_DM/Metal_Parts/02_Lower_Wrist_Link_L.step
reBotArm_control_py/urdf/00-arm-rs_asm-v3/meshes/pla3_green.STL
reBot-DevArm/hardware/reBot_B601_DM/Metal_Parts/03-Link3_L.step
reBotArm_control_py/urdf/00-arm-rs_asm-v3/meshes/gripper_right.STL
reBot-DevArm/hardware/reBot_B601_DM/Metal_Parts/02_Lower_Upper_Link_R.step
reBot-DevArm/hardware/reBot_B601_DM/3D_Printed_Parts/01_Lower_Arm_Filler_R.step
reBotArm_control_py/urdf/00-arm-rs_asm-v3/meshes/pla_left.STL
reBotArm_control_py/urdf/00-arm-rs_asm-v3/meshes/cnc_left.STL
reBot-DevArm/hardware/reBot_B601_DM/Metal_Parts/02_Rack.step
reBot-DevArm/hardware/reBot_B601_DM/Metal_Parts/03_Link1.step
reBot-DevArm/hardware/reBot_B601_DM/Metal_Parts/03_Link2.step
reBot-DevArm/hardware/reBot_B601_DM/Metal_Parts/03_Link3_L.step
reBot-DevArm/hardware/reBot_B601_DM/Metal_Parts/03_Link3_R.step
reBot-DevArm/hardware/reBot_B601_DM/Metal_Parts/03_Link5.step
