maolin2501/REBOOT_RS/reBot-DevArm/hardware/reBot_B601_DM/performance_testing/images/12Nm.png

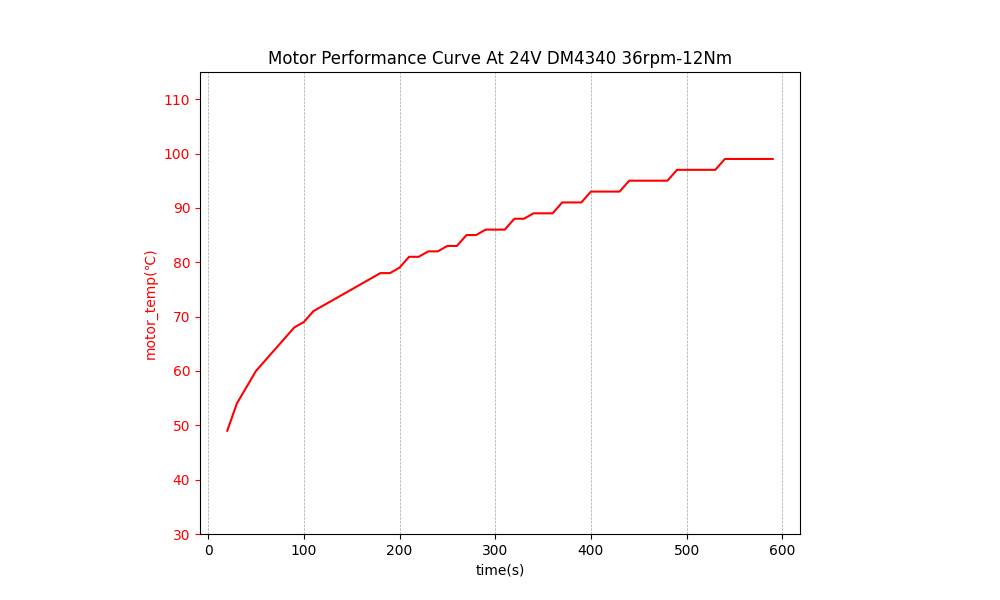
reBot-DevArm/hardware/reBot_B601_DM/performance_testing/images/12Nm.png
