maolin2501/REBOOT_RS/reBotArm_control_py/config/calibration_path.yaml

urdf_path: /home/wy/RS/SEEED/REBOOT/reBotArm_control_py/urdf/00-arm-rs_asm-v3/urdf/00-arm-rs_asm-v3.urdf
urdf_sha256: 79ad843b513c1a5be7536b6ba25438f84289f6336a28b172e2700d78db0f36dc
home_q:
- 0.0
- 1.0
- 1.2
- 0.0
- 0.0
- 0.0
segment_samples: 24
max_segment_dq: 0.35
limit_margin: 0.05
settle_time_s: 0.5
sample_time_s: 1.0
move_duration_s: 2.0
max_velocity_rad_s: 0.5
max_acceleration_rad_s2: 1.5
mit_kp:
- 80.0
- 80.0
- 80.0
- 15.0
- 15.0
- 15.0
mit_kd:
- 4.0
- 4.0
- 4.0
- 1.5
- 1.5
- 1.5
min_clearance_m: 0.0020923157626493234
total_path_dq: 223.13160000000002
collision_check_enabled: true
pose_reports:
- name: pose_01
  accepted: true
  reason: ''
- name: pose_02
  accepted: true
  reason: ''
- name: pose_03
  accepted: true
  reason: ''
- name: pose_04
  accepted: true
  reason: ''
- name: pose_05
  accepted: true
  reason: ''
- name: pose_06
  accepted: true
  reason: ''
- name: pose_07
  accepted: true
  reason: ''
- name: pose_08
  accepted: true
  reason: ''
- name: pose_09
  accepted: true
  reason: ''
- name: pose_10
  accepted: true
  reason: ''
- name: pose_11
  accepted: true
  reason: ''
- name: pose_12
  accepted: true
  reason: ''
- name: pose_13
  accepted: true
  reason: ''
- name: pose_14
  accepted: true
  reason: ''
- name: pose_15
  accepted: true
  reason: ''
- name: pose_16
  accepted: true
  reason: ''
- name: pose_17
  accepted: true
  reason: ''
- name: pose_18
  accepted: true
  reason: ''
- name: pose_19
  accepted: true
  reason: ''
- name: pose_20
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
  - 1.2933555555555554
  - -0.017777777777777837
  direction: null
- name: pose_40_transit_1
  kind: transit
  pose_name: pose_40
  q:
  - 0.0
  - 2.7061333333333337
  - 1.9414888888888888
  - 0.32532222222222223
  - 1.2462111111111112
  - -0.36055555555555563
  direction: null
