maolin2501/REBOOT_RS/reBotArm_control_py/config/calibration_poses.yaml

# 重力补偿标定 — 种子位姿（程序 1 输入）
# 单位: rad。approach_delta: 双向接近中转偏移，用于程序 2 消 Coulomb 摩擦。
# 由 scripts/gen_calib_poses.py 自动生成：joint1 固定不动；joint2 角度均匀分档；
# 所有位姿及双向接近点均通过限位+自碰撞+地面干涉检查。
# 位姿数 40 → 静止采样点约 80 个。

urdf: null  # null = 内置 00-arm-rs_asm-v3.urdf

home_q: [0.0000, 1.0000, 1.2000, 0.0000, 0.0000, 0.0000]

# 路径规划参数
segment_samples: 24
max_segment_dq: 0.35
limit_margin: 0.05

# 数据采集参数（程序 2 读取 path 文件中的副本）
settle_time_s: 0.5
sample_time_s: 1.0
move_duration_s: 2.0
max_velocity_rad_s: 0.5
max_acceleration_rad_s2: 1.5

# 程序 2 MIT 锁位增益（高刚度便于读静态力矩）
mit_kp: [80.0, 80.0, 80.0, 15.0, 15.0, 15.0]
mit_kd: [4.0, 4.0, 4.0, 1.5, 1.5, 1.5]

poses:
  - name: pose_01
    q: [0.0000, 0.1659, 1.0186, 0.8326, 0.4935, -0.6533]
    approach_delta: [0.00, 0.10, 0.10, 0.10, 0.10, 0.10]

  - name: pose_02
    q: [0.0000, 0.1965, 1.8351, -0.8771, 0.4837, 2.6508]
    approach_delta: [0.00, 0.10, 0.10, 0.10, 0.10, 0.10]

  - name: pose_03
    q: [0.0000, 0.1720, 2.8518, 0.4683, -1.1315, -0.3490]
    approach_delta: [0.00, 0.10, 0.10, 0.10, 0.10, 0.10]

  - name: pose_04
    q: [0.0000, 0.3571, 2.1226, -0.4859, 0.6550, -1.6792]
    approach_delta: [0.00, 0.10, 0.10, 0.10, 0.10, 0.10]

  - name: pose_05
    q: [0.0000, 0.4137, 0.5637, -0.4477, -0.0975, -1.4015]
    approach_delta: [0.00, 0.10, 0.10, 0.10, 0.10, 0.10]

  - name: pose_06
    q: [0.0000, 0.6266, 0.6606, -1.0375, -1.1433, 0.5914]
    approach_delta: [0.00, 0.10, 0.10, 0.10, 0.10, 0.10]

  - name: pose_07
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

  - name: pose_38
    q: [0.0000, 2.7200, 1.8314, 0.6775, 1.3405, 0.3250]
    approach_delta: [0.00, 0.10, 0.10, 0.10, 0.10, 0.10]

  - name: pose_39
    q: [0.0000, 2.9802, 2.8607, -0.8053, -1.2141, -1.9820]
    approach_delta: [0.00, 0.10, 0.10, 0.10, 0.10, 0.10]

  - name: pose_40
    q: [0.0000, 2.7576, 2.4268, -0.8073, 1.0162, -2.6600]
    approach_delta: [0.00, 0.10, 0.10, 0.10, 0.10, 0.10]
