maolin2501/REBOOT_RS/(commit log)

2026-06-09 Initial project snapshot
    [00-arm-rs_asm-v3.csv, 00-arm-rs_asm-v3.urdf, base_link.STL, cnc2.STL, cnc3.STL, cnc4.STL, cnc5.STL, cnc7.STL]
2026-06-09 Add complete project snapshot
    [00-arm-rs_asm-v3.csv, 00-arm-rs_asm-v3.urdf, 01-Rail-Bracket.step, 01_Arm_Handle.step, 01_BASE_Link.step, 01_BASE_Plate.step, 01_Finger.step, 01_Joint5_Cable Restraint_A.step]
