maolin2501/REBOOT_RS/(notices)

Notices in the files:
reBot-DevArm/README.md:
License: CERN-OHL-W-2.0
License: Apache-2.0
reBotArm_control_py/README_zh.md:
License: MIT
